MXACE/Edge-Device-Extension/README.md

# Edge-Device-Extension
Edge-Device, Node-Red, expansion board
https://docs.google.com/viewer?url=
