MXACE/Edge-Device-Extension/Extension-Board/COMMAND REFERENCE v1.1.pdf

# COMMAND REFERENCE v1.0

Extension board for the Edge Device

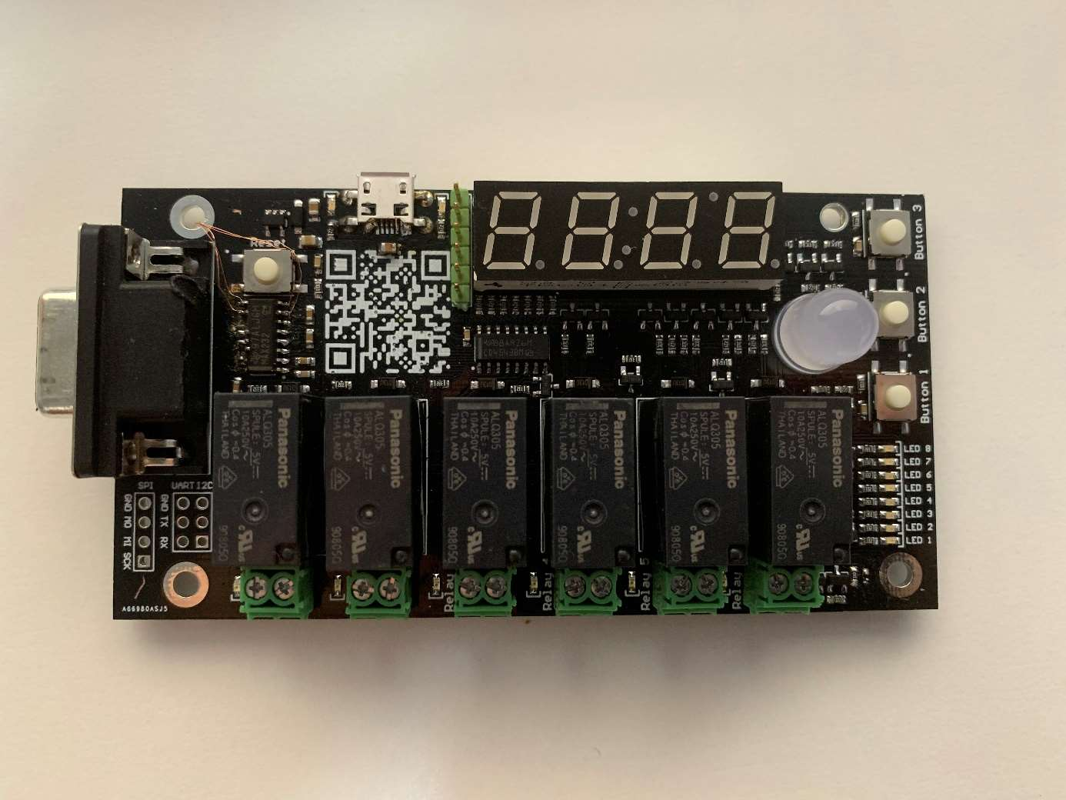
[picture p1: figure]

In this manual for the extension board v1.0 are supported command that can be sent over RS-232 (Serial) to control the parts on the PCB. Since the DSUB connector doesn’t supply the PCB with current, the Micro-USB connector on the top left has to be used. It is only for supply and can’t be used for communication.

### Serial settings:

Every sent command must end with a “;” to be completed, else it is still reading until he receives one. Every command received by the extension board comes with a “;” too.
Look at Page 9: Serial Settings for more detailed information.

### Baud-Rate: 115’200

## Inhalt

## RGB

You can set or read the current color of the RGB led. There are only certain colors available. Colorcode

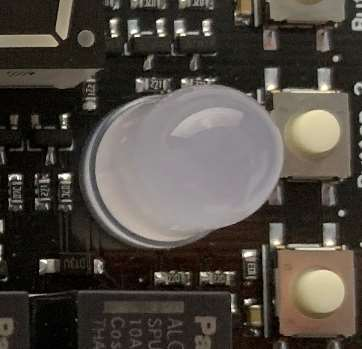
[picture p2: figure]

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
### SET

Set the RGB to the color with the color-code set.rgb.[color-code]
Example:
set.rgb.5;

### GET

Returns the current color of the RGB get.rgb
Example:
Received: | rgb.6;
Converted: | Yellow

## Relays

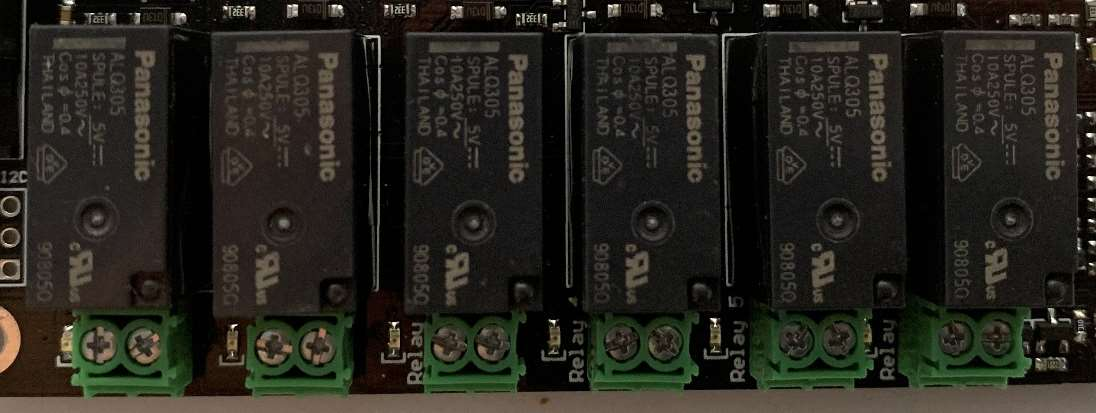
[picture p3: figure]

There are six relays that are able to switch 230V AC (but not recommended). If the relay is set a red led will shine on the left side of it.
You can connect it through the green terminal below it.
They are numbered from left to right and 1 to 6.

### SET

Turn the selected relay on or off
State:
0 -> off
1 -> on
set.relay.[relay number].[state]

Example:
set.relay.1.1;

### GET

Get the state of the relay get.relay.[relay number]
Example:
Received: | relay.3.1;
Converted: | ON

## LEDs

There are 8 green LEDs that can be turned on or off. They are numbered from 1 to 8.

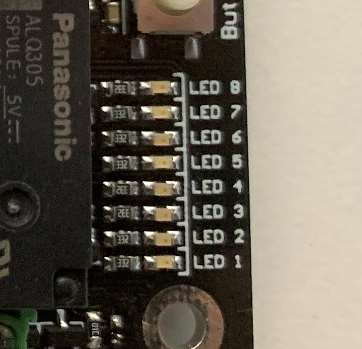
[picture p4: figure]

### SET

Turn the selected LED on or off State:
0 -> off
1 -> on
set.led.[led number].[state] Example:
set.led.4.1;

### GET

Returns the state of the relay get.led.[led number]

Example:
Received: | led.3.1;
Converted: | ON

## 7 Segment

The segment display can individually show numbers on each position, you can choose where the decimal point is, turn the colon or the upper point on. The display shines in green and can only show numbers.

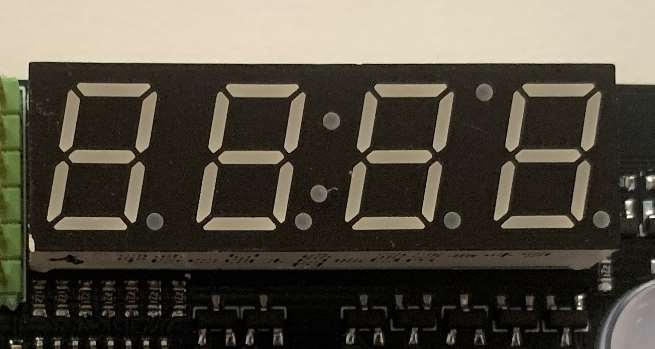
[picture p5: figure]

### SET

The position of the single digit: Pos. 1 -> X000
Pos. 2 -> 0X00
Pos. 3 -> 00X0
Pos. 4 -> 000X
dp pos -> decimal point position. Can be from 1 to 4. colon -> colon state, 1 = on, 0 = off.
upper -> upper point, 1 = on, 0 = off.

set.segment.[pos. 1][pos. 2][pos. 3][pos. 4].[dp pos].[colon].[upper]

Example:
set.segment.1234.0.1.0
Display shows: 12:34

## Temperature

Used to measure the room temperature.

Problem:
The longer the PCBs is turned on the more the sensor heat itself up. It will rise up a few Celsius.

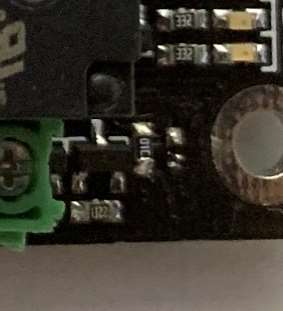
[picture p6: figure]

### GET

Returns the temperature as one number

get.temp

Example:
Received: | 2918;
Converted: | 29.18°C

### SHOW

The temperature can be show on the display with this command: set.showTemp.[state]
If you turn it off (state=0) the display shows 0000.

## Buttons

Used as an input source for the edge device
Sometimes it could trigger a fault state if the input can’t be read through the edge device. Only way to fix is, to reset (or repower) the extension board.

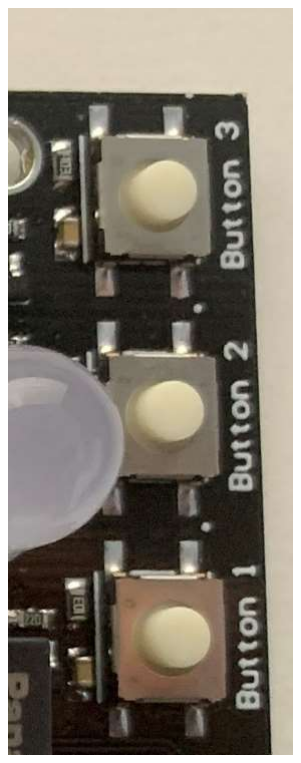
[picture p7: figure]

### GET

There is no command required. When a button is pressed one of the following returns can be received when pressed:
BUTTON1;
BUTTON2;
BUTTON3;

## Serial Settings

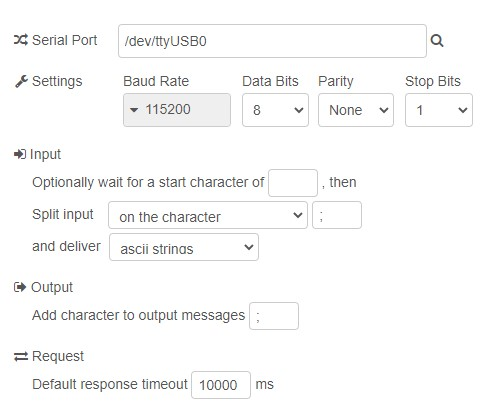
[picture p8: figure]

## Functions examples

All function codes can be found on the github.

### Read buttons

If the buttons are pressed you get into one of the following if-statements.
There you can set msg.payload that will be sent on the output of the function node.

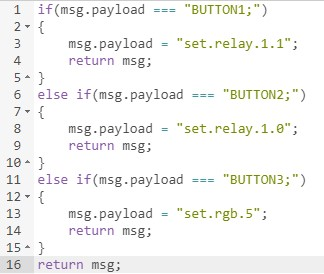
[picture p9: figure]

### Control the rgb led with the color picker node

Since they are only a few colors which the rgb led can show, it will automatically set the closest color. Color picker node settings:

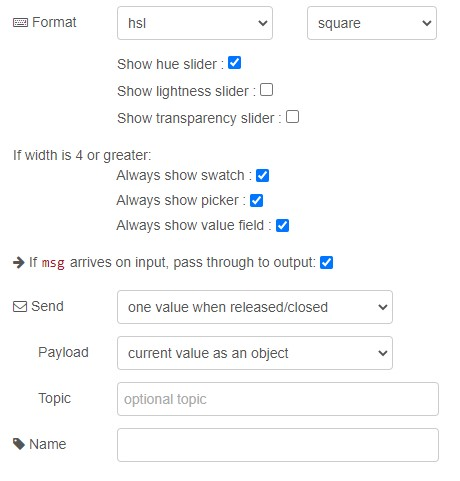
[picture p10: figure]

Function node

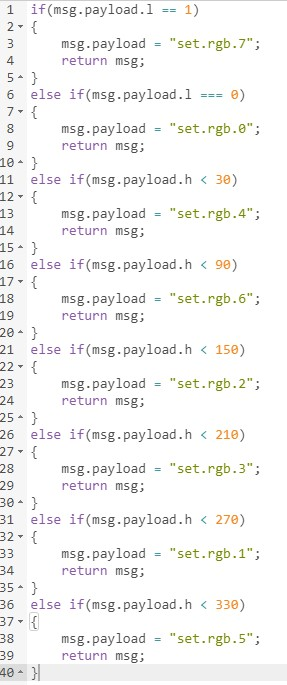
[picture p11: figure]

Set it up like this:
Color picker -> function -> serial out

### Use variables

Variables are here to store data if you need to, but there are a few types of them:
Temporary variable -> | Normal variable
Locally in function node -> | Context variable
Reachable from flow -> | Flow variable
Reachable from everywhere -> Global variable

Normal variable
It is initialized with “var” and followed by the name you want to give the variable.
If you wish to, you can declare it already at the beginning with “=” and a value, like a number a text in “”, or another variable writing its name there.

Here the variable names are VarA, VarB and VarC.
These types of variables only exists in the same function node and in every run of this node the variables will be forgotten (lose their saved values);

Context variables
Here you can save your variables locally in you function node without losing them every cycle.

Create/Set Flow variables
To create the variable, you must use the command:

Read Global variables
To read one of the existing variables you simply just add one of the following commands:

Flow variables.
This type of variables are based on the normal ones, but are reachable in the same flow. That means: multiple function nodes can read/change the variable.
Create/Set Flow variables
To create the variable, you must use the command:

Where “0” is the value of your variable (it can be another variable name).
Read Flow variables
To read one of the existing variables you simply just add one of the following commands:

You can either check the variable if it’s true or has a certain value.
Or you can set another new/existing variable with the value of the flow variable.

Global variables
Follows the same rules as Flow variables, but they are from every flow and function node reachable.

Create/Set Global Variables
To create the variable, you must use the command:

Read Global variables
To read one of the existing variables you simply just add one of the following commands:
