MXACE/Edge-Device-Extension/Projekt/Dokumentation/Plakat.pdf

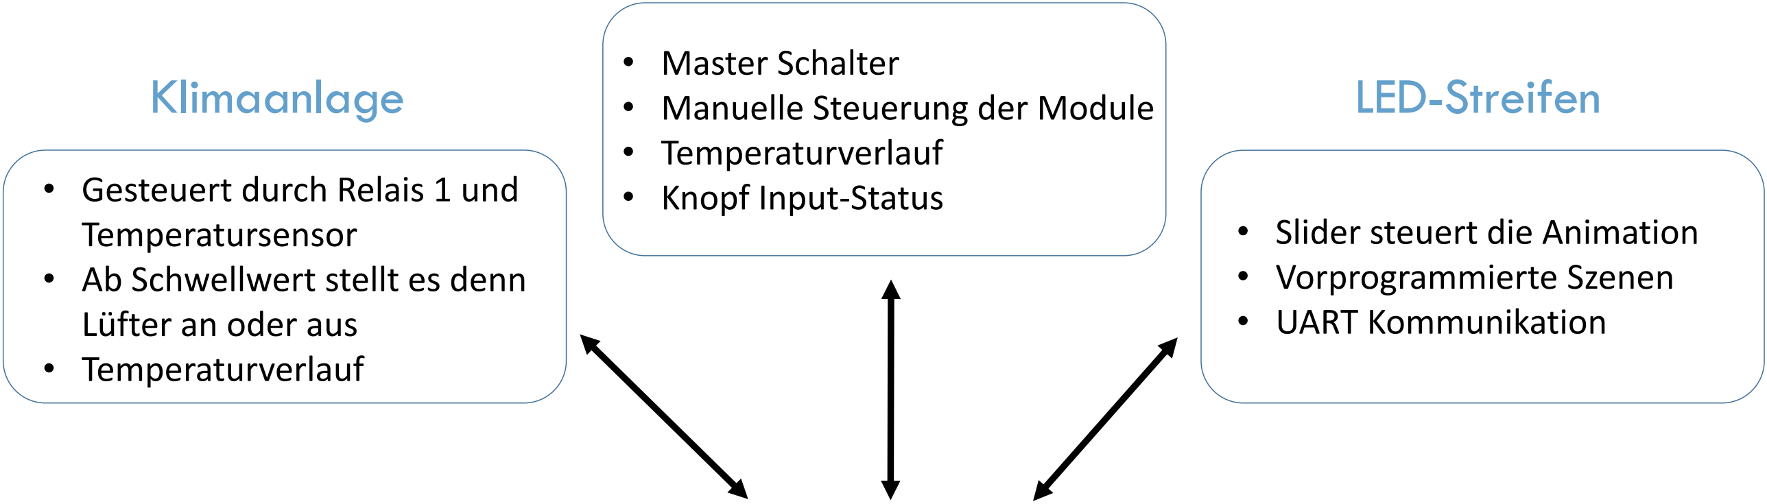
[picture p19: figure]
• Master Schalter • Manuelle Steuerung der Module • Temperaturverlauf • Knopf Input-Status; Klimaanlage; LED-Streifen; • Gesteuert durch Relais 1 und Temperatursensor • Ab Schwellwert stellt es denn Lüfter an oder aus • Temperaturverlauf; • Slider steuert die Animation • Vorprogrammierte Szenen • UART Kommunikation
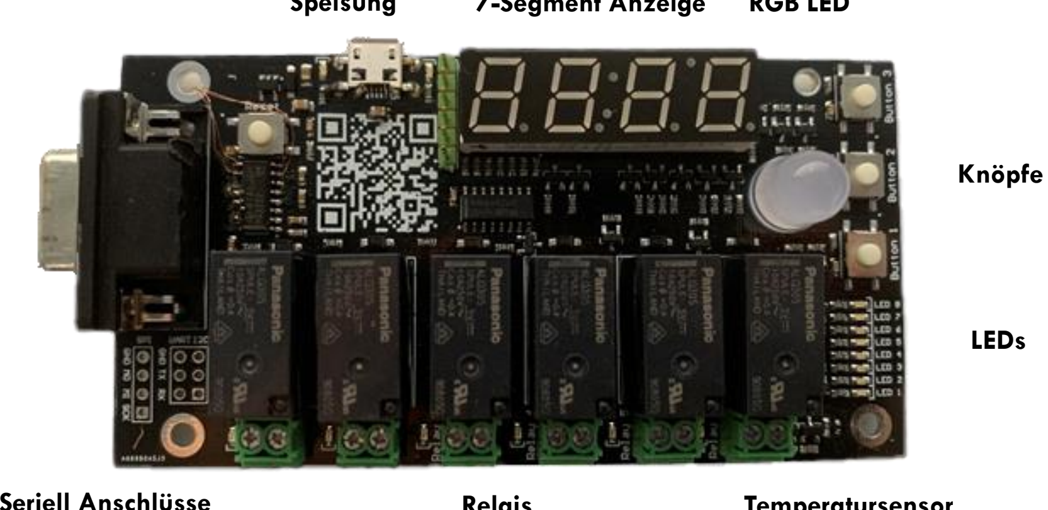
[picture p20: figure]
LEDs; Knöpfe
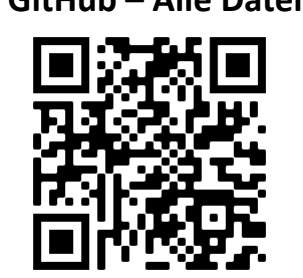
[picture p21: figure]

# Erweiterung für das Node-Red

## Marco Stauber

7-Segment Anzeige

Seriell Anschlüsse | Relais

RS232/
Seriell
Speisung | RGB LED

Temperatursensor

### Control Panel

Module
6x Schaltbare Relais (Schliesser)
8x Grüne LEDs
1x RGB LED (7 verschiedene Farben) 1x 4-Stellige 7-Segment Anzeige
3x Knöpfe
1x I

2C Anschluss (Nicht programmiert) 1x SPI Anschluss (Nicht programmiert) 1x Uart Anschluss

GitHub – Alle Daten
