MXACE/Edge-Device-Extension/Extension-Board/stückliste.xlsx

Part | What | Supplier | Supplier nr. | amount | price/piece | price total |  | digikey price |  | digikey new supply number
 |  |  |  |  |  | $0.00
 | Relays | seeed | G5NB-1A-E-DC5 | 6 | $0.69 | $4.14 |  | CHF 1.70 | CHF 51.13 | Z2771-ND |  | CHF 0.86 | CHF 25.87 | 255-3559-ND | CHF 20.70
 | STM32F401RBT6 | seeed | STM32F401RBT6 | 1 | $4.70 | $4.70 |  | CHF 4.32 | CHF 21.60 | 497-17428-ND |  |  | CHF 21.60 |  | CHF 17.28
 | max232 | seeed | MAX232DR | 1 | $0.46 | $0.46 |  | CHF 0.55 | CHF 2.75 | 296-14619-1-ND |  |  | CHF 2.75 |  | CHF 2.20
 | terminal 2pin 3.5mm | seeed | 1751248 | 6 | $1.05 | $6.30 |  | CHF 1.21 | CHF 36.21 | 277-5719-ND |  | CHF 0.45 | CHF 13.50 | 1984617 | CHF 10.80
 | led red | seeed | LTST-C191KRKT | 6 | $0.07 | $0.42 |  | CHF 0.19 | CHF 5.64 | 160-1447-1-ND |  | CHF 0.14 | CHF 4.20 | 732-4978-1-ND | CHF 3.36
 | led green | seeed | LTST-C191KGKT | 10 | $0.07 | $0.75 |  | CHF 0.19 | CHF 9.40 | 160-1446-1-ND |  | CHF 0.16 | CHF 7.95 | 732-12017-1-ND | CHF 6.36
 | bcd 7segment | seeed | CD4543BM96 | 1 | $0.47 | $0.47 |  | CHF 0.38 | CHF 1.90 | 296-31539-1-ND |  |  | CHF 1.90 |  | CHF 1.52
 | button | seeed | EVQQ2U02W | 4 | $0.18 | $0.72 |  | CHF 0.28 | CHF 5.60 | P12954SCT-ND |  | CHF 0.12 | CHF 2.40 | P12932SCT-ND | CHF 1.92
 | 3.3V | seeed | SPX1117M3-L-3-3 / TR | 1 | $0.22 | $0.22 |  | CHF 0.30 | CHF 1.49 | 1016-1848-1-ND | anderer footprint! | CHF 0.11 | CHF 0.55 | 576-4764-1-ND | CHF 0.44
 | temperatur sensor | seeed | KTY81 / 110,112 | 1 | $0.02 | $0.02 |  | CHF 1.42 | CHF 7.10 | 568-1003-ND | anderer footprint! | CHF 0.22 | CHF 1.10 | 296-TMP6131DECRCT-ND | CHF 0.88
 | schotky diode | seeed | PMEG4010EH, 115 | 7 | $0.08 | $0.55 |  | CHF 0.23 | CHF 8.18 | 1727-3880-1-ND |  | CHF 0.13 | CHF 4.59 | 1655-1926-1-ND | CHF 3.67
 | 26mhz crystal | seeed | SX25Y026000B91T | 1 | $0.10 | $0.10 |  | CHF 0.00 | CHF 0.00 |  |  | CHF 0.35 | CHF 1.75 | SER4105CT-ND | CHF 1.40
 | 7 segment | digikey | https://www.digikey.ch/product-detail/de/vishay-semiconductor-opto-division/TDCG1060M/TDCG1060M-ND/4074707 | 1 | $2.85 | $2.85 |  | CHF 2.85 | CHF 14.25 | TDCG1060M-ND |  |  | CHF 14.25 |  | CHF 11.40
 | transistor | seeed | MMBT3904-7-F | 24 | $0.02 | $0.50 |  | CHF 0.04 | CHF 5.22 | MMBT3904-FDICT-ND |  |  | CHF 5.22 |  | CHF 4.18
 | 10uF 0805 25V | seeed | GRM21BR61E106KA73L | 5 | $0.05 | $0.26 |  | CHF 0.18 | CHF 4.40 | 490-5523-1-ND |  | CHF 0.14 | CHF 3.60 | 1276-6454-1-ND | CHF 2.88
 | 100nF 0603 50V | seeed | C0603C104Z3VACTU | 11 | $0.02 | $0.22 |  | CHF 0.03 | CHF 1.70 | 399-1100-1-ND |  |  | CHF 1.71 |  | CHF 1.36
 | usb micro b | seeed | 473460001 | 1 | $1.30 | $1.30 |  | CHF 1.03 | CHF 5.15 | WM17141CT-ND | anderer footprint! | CHF 0.36 | CHF 1.80 | 2057-MCR-B-S-RA-SMT-EH4B-T/RCT-ND | CHF 1.44
 | 3k ohm 0603 | seeed | RC0603JR-073K3L | 14 | $0.0013 | $0.02 |  | CHF 0.02 | CHF 1.33 | 311-3.3KGRCT-ND |  |  | CHF 1.33 |  | CHF 1.06
 | 165k ohm 0603 | seeed | RC0603FR-07165KL | 8 | $0.002 | $0.02 |  | CHF 0.02 | CHF 0.92 | 311-165KHRCT-ND |  |  | CHF 0.92 |  | CHF 0.74
 | 270 ohm 0603 | seeed | RC1206FR-07270RL | 21 | $0.01 | $0.10 |  | CHF 0.02 | CHF 2.42 | 311-270HRCT-ND |  |  | CHF 2.42 |  | CHF 1.93
 | 11k ohm 0603 | seeed | RC0603FR-0711K5L | 10 | $0.003 | $0.03 |  | CHF 0.02 | CHF 1.15 | 311-11.5KHRCT-ND |  |  | CHF 1.15 |  | CHF 0.92
 | 22pf 0603 50V | seeed | CL10C220JB8NNNC | 2 | $0.01 | $0.02 |  | CHF 0.06 | CHF 0.61 | 1276-1023-1-ND |  |  | CHF 0.61 |  | CHF 0.49
 | 10k ohm 0603 | seeed | RC0603JR-0710KL | 5 | $0.001 | $0.01 |  | CHF 0.02 | CHF 0.47 | 311-10KGRCT-ND |  |  | CHF 0.47 |  | CHF 0.38
 | 1.3k ohm 0603 | seeed | RC0603JR-071K3L | 1 | $0.0013 | $0.0013 | 1 | CHF 0.02 | CHF 0.10 | 311-1.3KGRCT-ND |  |  | CHF 0.19 |  | CHF 0.15
 | dsub 9 | digikey | 618009231121 | 1 | $2.63 | $2.63 |  | CHF 2.63 | CHF 13.15 | 732-618009231121-ND |  |  | CHF 13.15 |  | CHF 10.52
 | 1uf 0603 25V | seeed | GCM188R71E105KA64D | 8 | $0.07 | $0.53 |  | CHF 0.19 | CHF 7.64 | 490-10673-1-ND |  | CHF 0.07 | CHF 2.96 | 311-1445-1-ND | CHF 2.37
 | FRB | seeed | BLM18AG102SN1D | 1 | $0.02 | $0.02 |  | CHF 0.10 | CHF 0.50 | 490-1015-1-ND |  |  | CHF 0.50 |  | CHF 0.40
 | 390 ohm 0805 | seeed | RC0805JR-07390RL | 1 | $0.002 | $0.002 | 1 | CHF 0.03 | CHF 0.17 | 311-390ARCT-ND |  |  | CHF 0.34 |  | CHF 0.28
 |  |  |  | 159 |  | $27.36 |  |  | $210.18 |  |  |  | CHF 138.78 |  | CHF 111.03 | CHF 27.76
 |  |  |  |  | SMD | THT |  |  |  |  |  | SMD | THT | mixed
 |  |  |  |  | 144 | 13 |  |  |  |  |  | 144 | 14 | 1
