MXACE/Edge-Device-Extension/Extension-Board/PCB/FilesForOrder/BOM.xls

 |  | xxxx xxxx xxxxx xxPCS BOM (Sample Bill of Materials)
Quantity | Designator | Description | Value | Footprint | Manufacturer | Part Number
8 | C1,C2,C3,C4,C5,C15,C16,C27 | 0603 | CAP CER 1UF 25V X5R 0603 | 0603 | Yageo | CC0603KRX5R8BB105
11 | C6,C7,C8,C9,C17,C18,C19,C20,C21,C24,C26 | 0603 | CAP CER 0.1UF 25V Y5V 0603 | 0603 | Murata Electronics | C0603C104Z3VACTU
5 | C10,C11,C12,C23,C25 | 0805 | CAP CER 10UF 25V X5R 0805 | 0805 | Samsung Electro-Mechanics | CL21A106KAYNNNG
2 | C13,C14 | 0603 | CAP CER 22PF 50V C0G/NP0 0603 | 0603 | Microchip | CL10C220JB8NNNC
7 | D1,D3,D5,D7,D9,D11,D24 | SOD-123FL | SCHOTTKY 30V SOD-123FL | SOD-123FL | SMC Diode Solutions | DSS13UTR
6 | D2,D4,D6,D8,D10,D12 | 0603 | LED RED CLEAR 0603 SMD | 0603 | Würth Elektronik | 150060RS75000
10 | D15,D16,D17,D18,D19,D20,D21,D22,D23,D25 | 0603 | LED GREEN DIFFUSED 0603 SMD | 0603 | Würth Elektronik | 150060VS55040
6 | K1,K2,K3,K4,K5,K6 |  | RELAY GEN PURPOSE SPST 10A 5V |  | Panasonic Electric Works | ALQ305
1 | L1 | 0603 | FERRITE BEAD 1 KOHM 0603 1LN | 0603 | Murata Electronics | BLM18AG102SN1D
6 | P3,P4,P5,P6,P7,P8 |  | TERM BLK 2POS SIDE ENT 3.5MM PCB |  | Phoenix Contact | 1984617
1 | P9 |  | MICRO USB, TYPE B, RIGHT ANGLE, |  | Muruta | MCR-B-S-RA-SMT-EH4B-T/R
21 | R1,R4,R7,R10,R12,R14,R16,R17,R20,R22,R23,R24,R25,R26,R27,R28,R29,R30,R31,R55,R56 | 0603 | RES SMD 270 OHM 1% 1/10W 0603 | 0603 | Yageo | RC0603FR-07270RL
14 | R2,R5,R8,R11,R13,R15,R40,R42,R44,R46,R48,R50,R52,R54 | 0603 | RES SMD 3.3K OHM 5% 1/10W 0603 | 0603 | Yageo | RC0603JR-073K3L
5 | R3,R6,R9,R59,R60 | 0603 | RES SMD 10K OHM 5% 1/10W 0603 | 0603 | Yageo | RC0603JR-0710KL
10 | R18,R19,R21,R32,R33,R34,R35,R36,R37,R38 | 0603 | RES SMD 11.5K OHM 1% 1/10W 0603 | 0603 | Yageo | RC0603FR-0711K5L
8 | R39,R41,R43,R45,R47,R49,R51,R53 | 0603 | RES SMD 165K OHM 1% 1/10W 0603 | 0603 | Yageo | RC0603FR-07165KL
1 | R57 | 0603 | RES SMD 1.3K OHM 5% 1/10W 0603 | 0603 | Yageo | RC0603JR-071K3L
1 | R58 | 0603 | RES SMD 390 OHM 5% 1/8W 0805 | 0603 | Yageo | RC0805JR-07390RL
4 | S1,S2,S3,S4 |  | SWITCH TACTILE SPST-NO 0.02A 15V |  | Panasonic Electronic Components | EVQ-Q2B03W
24 | T1,T2,T3,T4,T5,T6,T7,T8,T9,T10,T11,T12,T13,T14,T15,T16,T17,T18,T19,T20,T21,T22,T23,T24 | SOT23-3 | TRANS NPN 40V 0.2A SMD SOT23-3 | SOT23-3 | Diodes Incorporated | MMBT3904-7-F
1 | U1 | 16-SOIC | IC TRANSCEIVER FULL 2/2 16SOIC | 16-SOIC | Texas Instruments | MAX232DR
1 | U2 | 16-SOIC | IC DRVR 7 SEGMENT 1 DIGIT 16SOIC | 16-SOIC | Texas Instruments | CD4543BM96
1 | U3 | 0402 | SENSOR PTC 10KOHM 1% X1SON | 0402 | Texas Instruments | TMP6131DECR
1 | U4 | 64-LQFP | IC MCU 32BIT 128KB FLASH 64LQFP | 64-LQFP | STMicroelectronics | STM32F401RBT6
1 | U5 | SOT23-5 | IC REG LINEAR 3.3V 300MA SOT23-5 | SOT23-5 | Microchip Technology | MIC5504-3.3YM5-TR
1 | Y1 | 4-SMD | CRYSTAL 26.00 MHZ 9.0PF SMD | 4-SMD | EPSON | TSX-3225 26.0000MF09Z-AC0
1 | D14 | 16-DIP | CLOCKMODULE 10MM GREEN M.PLEX C. | 16-DIP | TDCG1060M-ND | TDCG1060M
1 | J1 |  | WR-DSUB FEMALE ANGLED PCB CONNEC |  | Würth Elektronik | 618009231121
