MXACE/Edge-Device-Extension/Extension-Board/PCB/PCB_Project/PCB Project Outputs/BOM/Bill of Materials-PCB_Project.xls

Comment | Description | Designator | Footprint | LibRef | Manufacturer | Manufacturer Part Number | Note | Quantity | Supplier | Supplier Part Number | Library Reference
1uF | capacitor | C1, C2, C3, C4, C5, C15, C16, C27 | CAP_0603i_1608m -N | Cap |  |  |  | 8 |  |  | Cap
100nF | capacitor | C6, C7, C8, C9, C17, C18, C19, C20, C21, C24, C26 | CAP_0603i_1608m -N | Cap |  |  |  | 11 |  |  | Cap
10uF | capacitor | C10, C11, C12, C23, C25 | CAP_0805i_2012m -N | Cap |  |  |  | 5 |  |  | Cap
22pF | capacitor | C13, C14 | CAP_0603i_1608m -N | Cap |  |  |  | 2 |  |  | Cap
Diode Schottky | Schottky Diode | D1, D3, D5, D7, D9, D11, D24 | SOD123 | Diode Schottky |  |  |  | 7 |  |  | Diode Schottky
Orange | LED; SMD; 0603; orange; 45-90mcd; 1.6x0.8x0.55mm; 130Â°; 2Ã·2.4V; 20mA | D2, D4, D6, D8, D10, D12 | *0603 | LTST-C191KFKT |  |  |  | 6 |  |  | LTST-C191KFKT
848 |  | D13 | Adafruit-848 | Adafruit-848 |  |  |  | 1 |  |  | Adafruit-848
7 Segment |  | D14 | TDCG1060M | TDCG1060M |  |  |  | 1 |  |  | TDCG1060M
Grün | LED; SMD; 0603; grün; 35mcd; 1.6x0.8x0.55mm; 130Â°; 2Ã·2.V; 20mA | D15, D16, D17, D18, D19, D20, D21, D22, D23, D25 | *0603 | LTST-C191KGKT |  |  |  | 10 |  |  | LTST-C191KGKT
618009231121 | Female PCB Connector with Hex Screw WR-DSUB, 8.08 mm, Angled, 9 pins | J1 | 618009231121 | CMP-1502-00200-1 | Wurth Elektronik |  |  | 1 |  |  | CMP-1502-00200-1
ALQ305 | LQ Relays, 5 V Coil Voltage, 200 mW Nominal Operating Power, -40 to 85 degC, 4-Pin LQ, Carton, Case, RoHS | K1, K2, K3, K4, K5, K6 | PNSC-LQ-4-2000x1000x1600_V | CMP-1503-00188-1 | Panasonic |  |  | 6 |  |  | CMP-1503-00188-1
Inductor | Inductor | L1 | IND_0603i_1608m -L | Inductor |  |  |  | 1 |  |  | Inductor
Header 4 | Header, 4-Pin | P1 | HDR1X4 | Header 4 |  |  |  | 1 |  |  | Header 4
Header 3X2 | Header, 3-Pin, Dual row | P2 | HDR2X3 | Header 3X2 |  |  |  | 1 |  |  | Header 3X2
Header 2 | Header, 2-Pin | P3, P4, P5, P6, P7, P8 | 3.5MM Phoenix Contact 1984617 | Header 2 |  |  |  | 6 |  |  | Header 2
USB Micro B |  | P9 | MCR-B-S-RA-SMT-EH4B-T/R | USB Mikro B |  |  |  | 1 |  |  | USB Mikro B
Temp | Single Pad or Testpoint | P10 | Pad_3x3mm | Pad |  |  |  | 1 |  |  | Pad
JTDI | Single Pad or Testpoint | P11 | Pad_0603 | Pad |  |  |  | 1 |  |  | Pad
MC | Single Pad or Testpoint | P12 | Pad_3x3mm | Pad |  |  |  | 1 |  |  | Pad
Header 6 | Header, 6-Pin | P13 | HDR1X6 | Header 6 |  |  |  | 1 |  |  | Header 6
270 | Resistor | R1, R4, R7, R10, R12, R14, R16, R17, R20, R22, R23, R24, R25, R26, R27, R28, R29, R30, R31, R55, R56 | RES_0603i_1608m -N | Res |  |  |  | 21 |  |  | Res
3k | Resistor | R2, R5, R8, R11, R13, R15, R40, R42, R44, R46, R48, R50, R52, R54 | RES_0603i_1608m -N | Res |  |  |  | 14 |  |  | Res
10k | Resistor | R3, R6, R9, R59, R60 | RES_0603i_1608m -N | Res |  |  |  | 5 |  |  | Res
11k | Resistor | R18, R19, R21, R32, R33, R34, R35, R36, R37, R38 | RES_0603i_1608m -N | Res |  |  |  | 10 |  |  | Res
165k | Resistor | R39, R41, R43, R45, R47, R49, R51, R53 | RES_0603i_1608m -N | Res |  |  |  | 8 |  |  | Res
1.3k | Resistor | R57 | RES_0603i_1608m -N | Res |  |  |  | 1 |  |  | Res
390 | Resistor | R58 | RES_0805i_2012m -N | Res |  |  |  | 1 |  |  | Res
10k,ptc | temp sensor, ptc 10k | R61 | RES_0402i_1005m -N | Res |  |  |  | 1 |  |  | Res
EVQ-Q2U02W | White Button Tactile Switch, Single Pole Single Throw (SPST) 20 mA @ 15 V dc 0.7mm | S1, S2, S3, S4 | EVQQ2 | EVQ-Q2U02W |  |  |  | 4 |  |  | EVQ-Q2U02W
Part Number: MMBT3904-7-F | No Description Available | T1, T2, T3, T4, T5, T6, T7, T8, T9, T10, T11, T12, T13, T14, T15, T16, T17, T18, T19, T20, T21, T22, T23, T24 | SOT-23-M | MMBT3904-7-F |  |  |  | 24 |  |  | MMBT3904-7-F
MAX232DR | Dual EIA-232 Driver / Receiver, 0 to 70 degC, 16-Pin SOIC (D), Green (RoHS & no Sb/Br) | U1 | D0016A_N | CMP-0299-00150-2 |  |  |  | 1 |  |  | CMP-0299-00150-2
CD4543BM96 | CMOS BCD-to-7-Segment Latch / Decoder / Driver for Liquid-Crystal Displays, 3 V, -55 to 125 degC, 16-pin SOIC (D16), Green (RoHS & no Sb/Br) | U2 | D0016A_L | CMP-0388-00008-2 | Texas Instruments |  |  | 1 |  |  | CMP-0388-00008-2
MIC5504-3.3YM5-TR | Single LDO, 2.5 to 5.5 V, Fixed Out 3.3 V, 0.3 A, -40 to 125 degC, 5-Pin SOT-23 (M5), RoHS, Tape and Reel | U3 | MCHP-SOT-23-M5_V | CMP-2000-07604-1 | Microchip |  |  | 1 |  |  | CMP-2000-07604-1
STM32F401RBT6 | ARM Cortex-M4 32-bit MCU+FPU, 105 DMIPS, 128 kB Flash, 64 kB Internal RAM, 48 I/Os, 64-pin LQFP, -40 to 85 degC, Tray | U4 | STM-LQFP64_L | CMP-0243-00094-2 | STMicroelectronics |  |  | 1 |  |  | CMP-0243-00094-2
XTAL3 | Industrial Ceramic Resonator | Y1 | TSX-3225 2*2.5 | XTAL3 |  |  |  | 1 |  |  | XTAL3
