MXACE/Edge-Device-Extension/Projekt/Klimaanlage/cad/lüfterhalter.SLDPRT

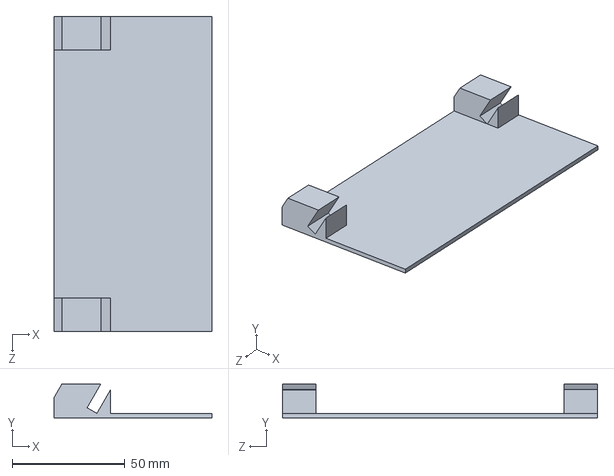
[picture p24: CAD file, 2020-10-02]
Projekt/Klimaanlage/cad/lüfterhalter.SLDPRT
70.0 x 15.0 x 140.0 mm
