MXACE/Edge-Device-Extension/(list of files, cad)

Other CAD files:
Projekt/Klimaanlage/cad/lüfterhalter.STL
