MXACE/Edge-Device-Extension/Extension-Board/PCB/PCB_Project/PCB Project Outputs/Schematics.PDF

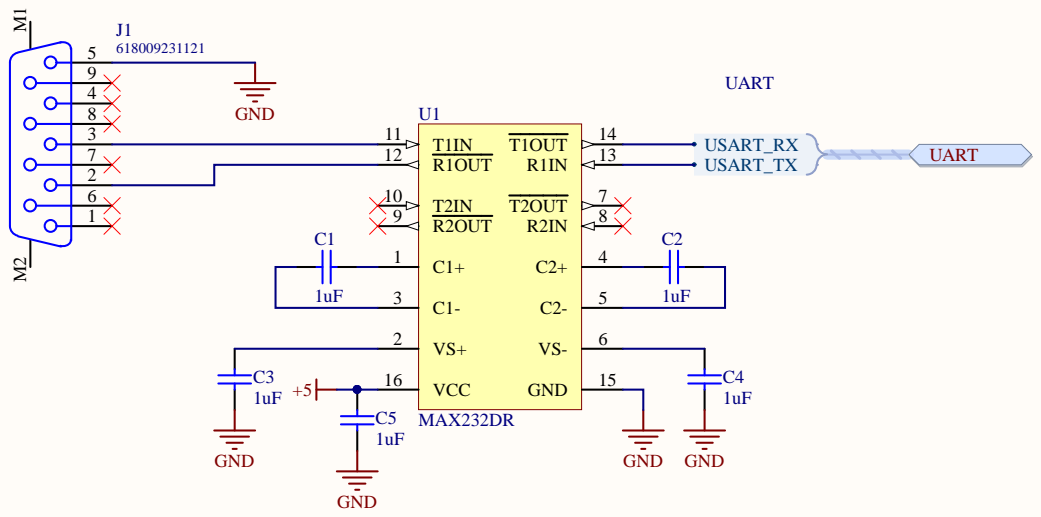
[picture p25: page 1]

Pro jec t : *

Dra w i n g n u m ber : * Rev: Dat e : 25. 09. 202 0 14: 03: 5 2 | For m a t : A 3 | Labor ato ry : Dra w n b y : | S h eet : C O M . SchDo c Pag e o f

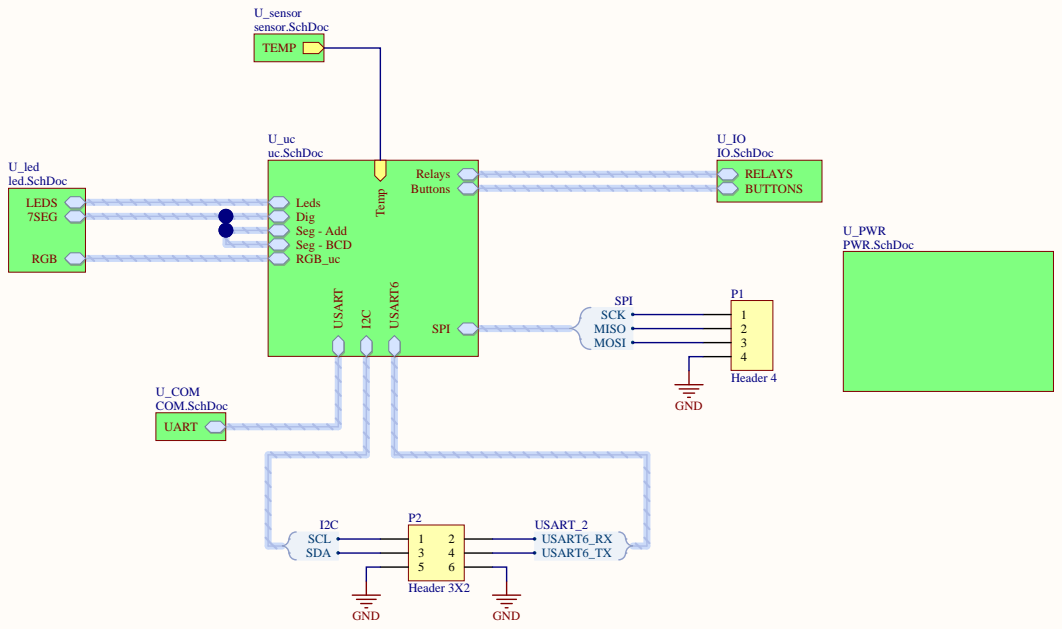
[picture p26: page 2]

Project: *

Drawing number: * Rev: * Date: 25.09.2020 14:03:53 | Format: A3 | Laboratory: * Drawn by: | Sheet: extension.SchDoc Page * of *

D:\onedrive\OneDrive - TBZ\node-red\extensionv1.0\PCB_Project\extension.SchDoc

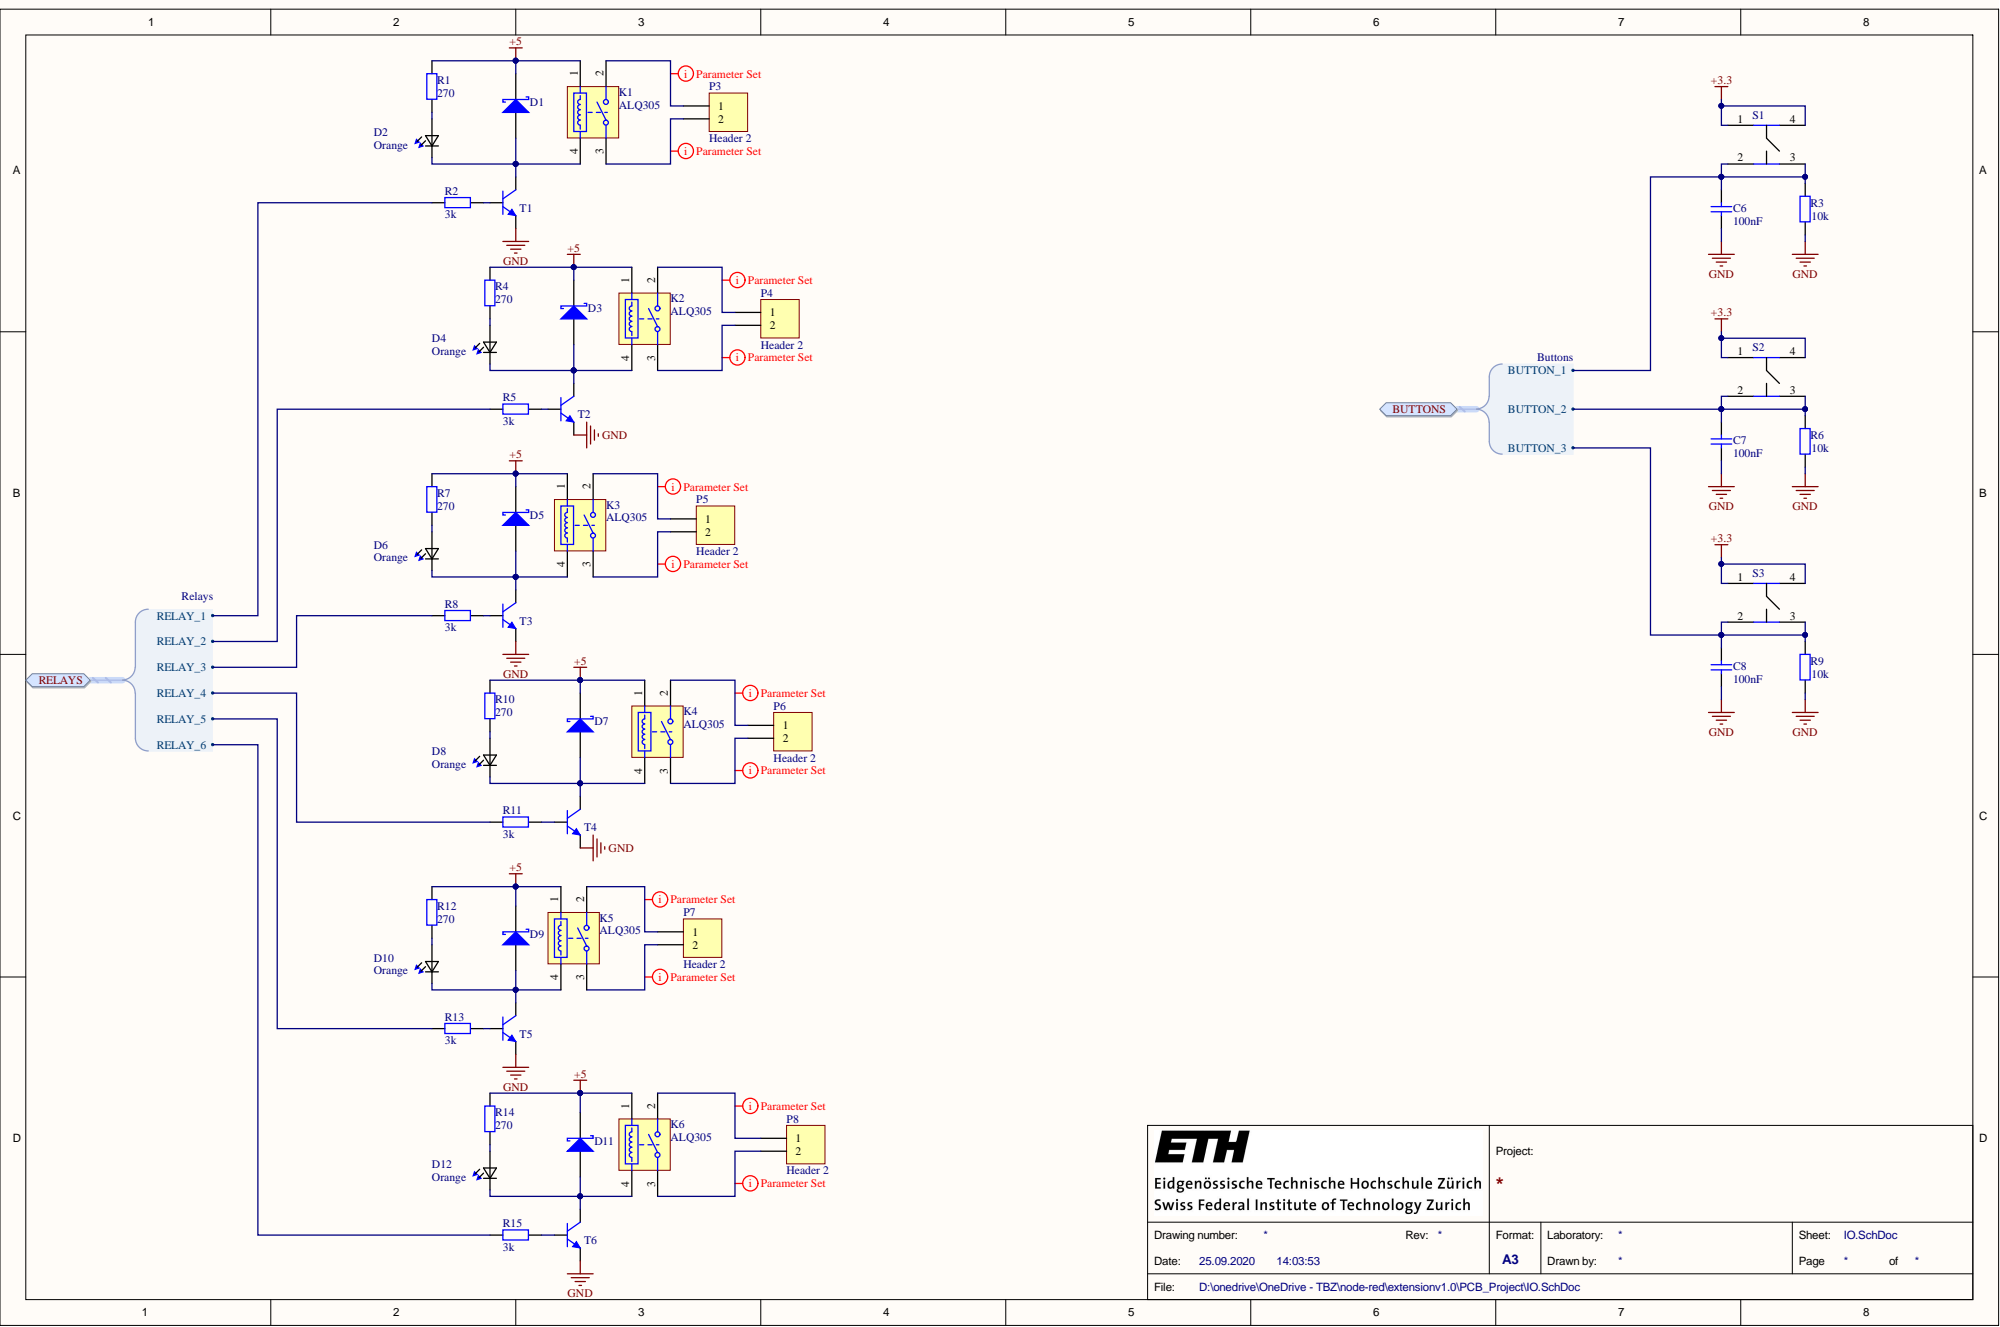
[picture p27: page 3]

i Parameter Set i Parameter Set i Parameter Set

D6 Orange

D8 Orange

D10 Orange

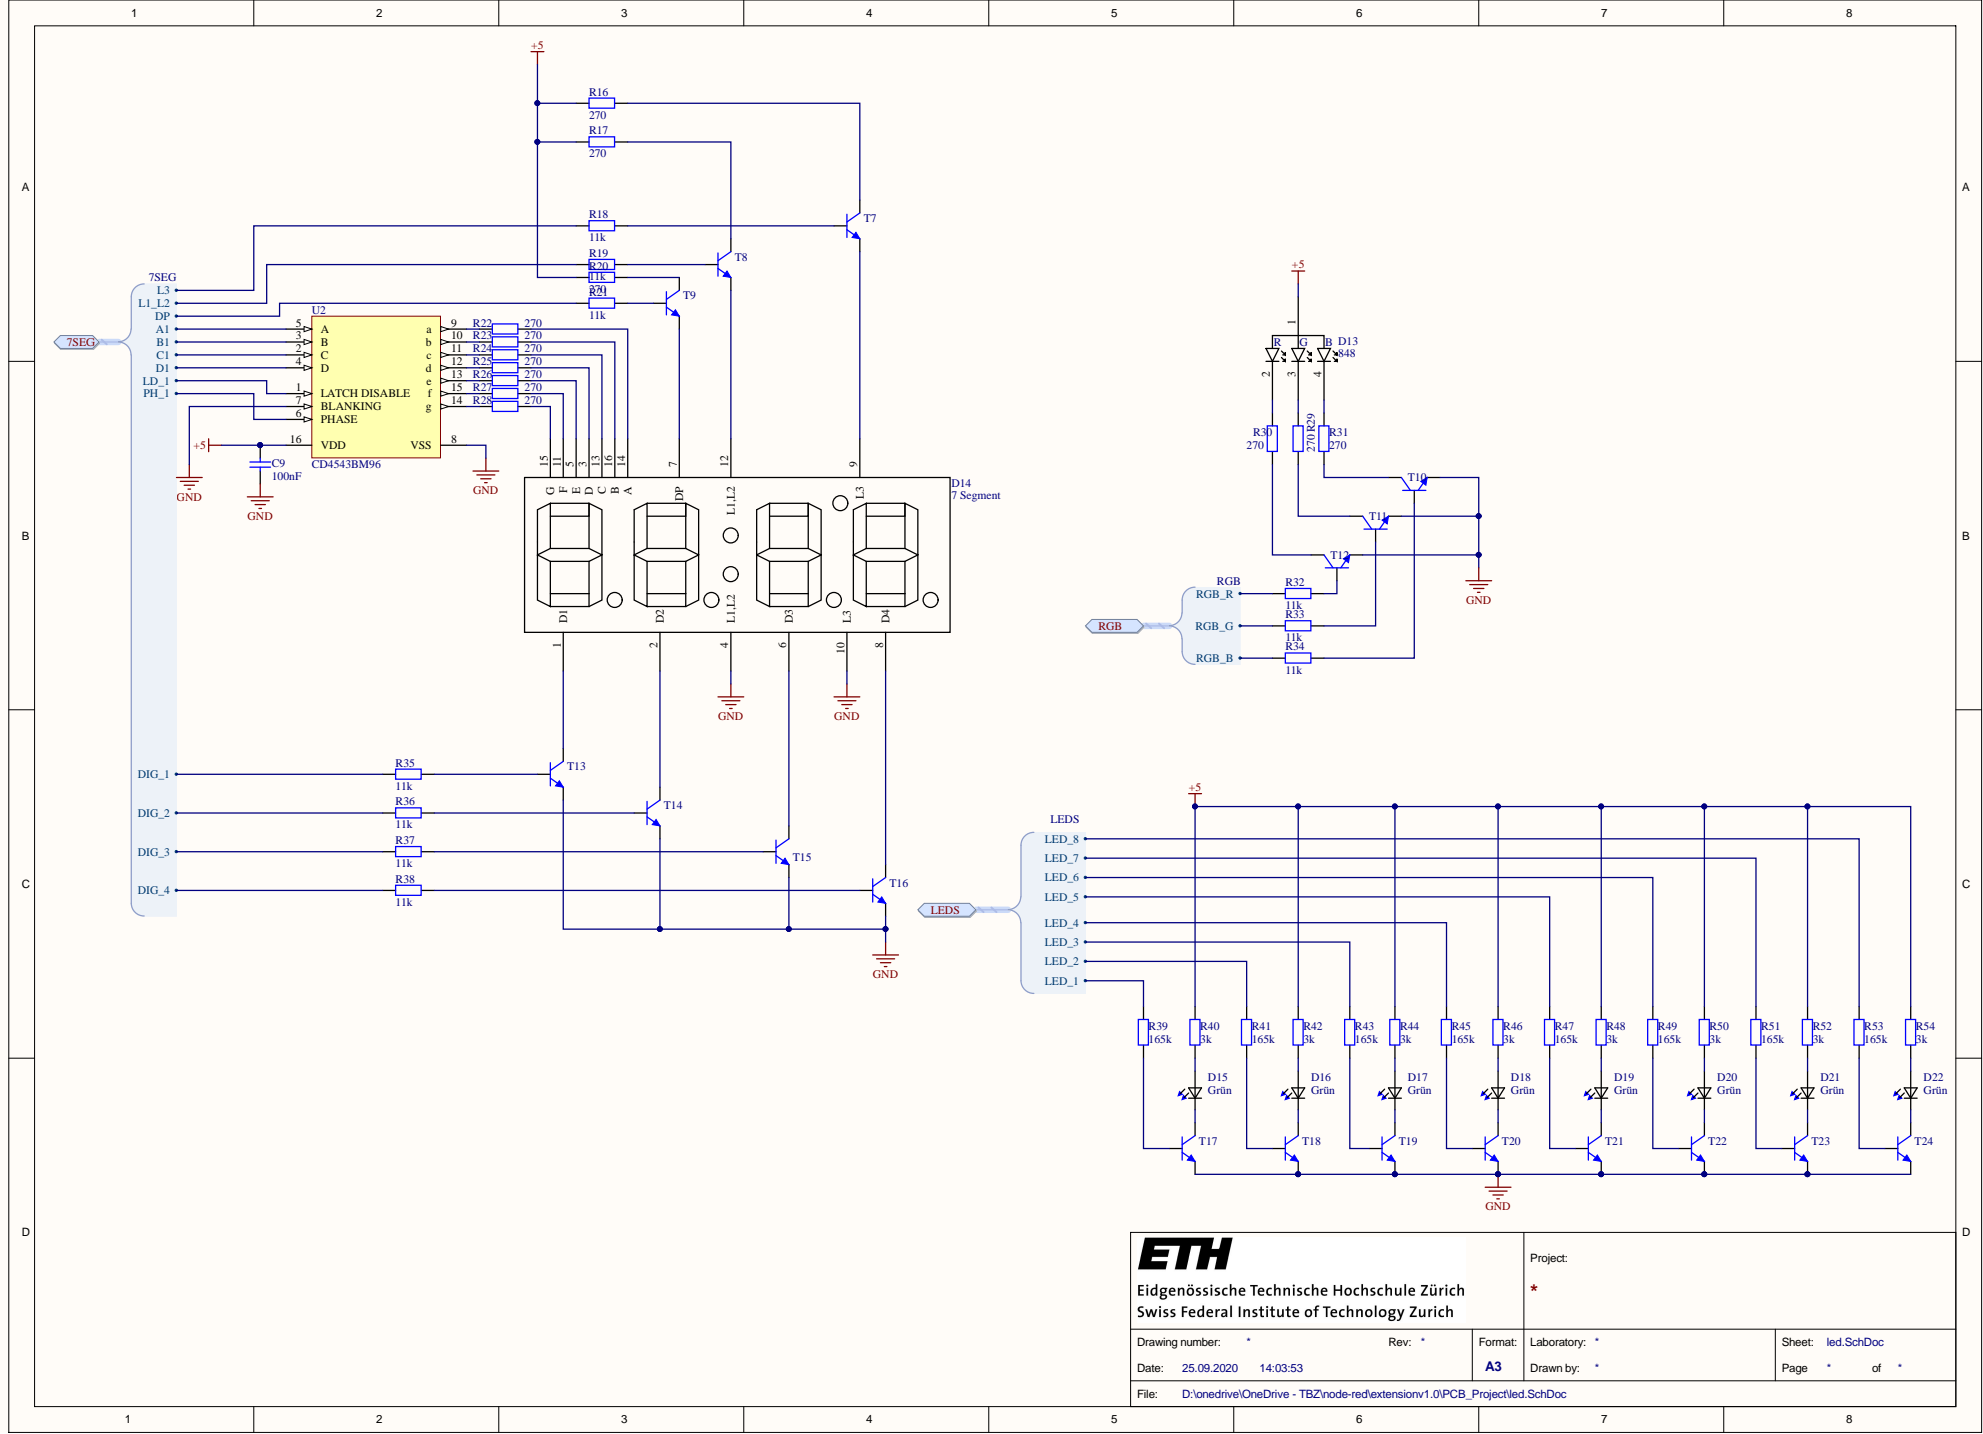
[picture p28: page 4]

A 5 b c d e g
C 2 B 3 | 10 R23 | | 270

D 4 | 12 R25 | | 270
LATCH DISABLE 1 | 13 R26 | | 270

PHASE 6 BLANKING 7 | R28 | 270

Project: *

Drawing number: * Rev: * Date: 25.09.2020 14:03:53 | Format: A3 | Laboratory: * Drawn by: | Sheet: led.SchDoc Page * of *

D:\onedrive\OneDrive - TBZ\node-red\extensionv1.0\PCB_Project\led.SchDoc

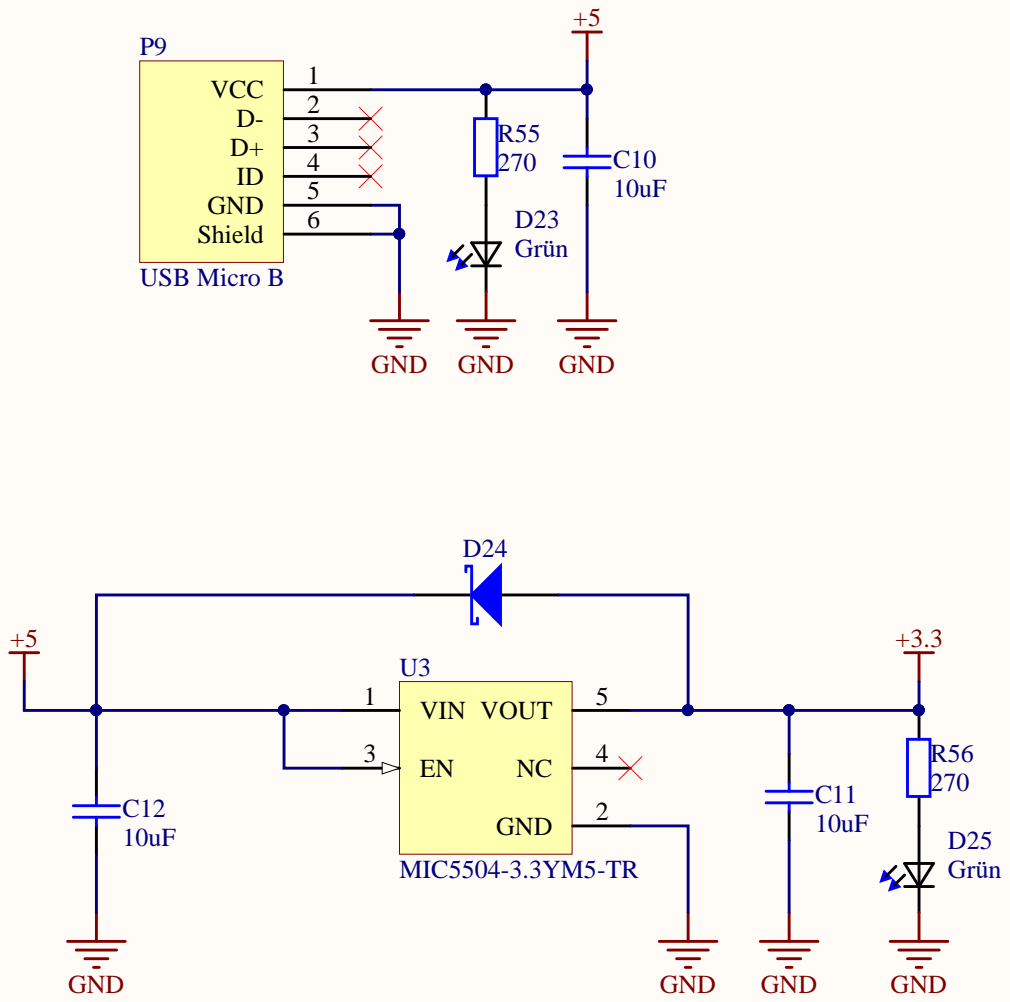
[picture p29: page 5]

Project: *

Drawing number: * Rev: * Date: 25.09.2020 14:03:54 | Format: A3 | Laboratory: * Drawn by: | Sheet: PWR.SchDoc Page * of *

D:\onedrive\OneDrive - TBZ\node-red\extensionv1.0\PCB_Project\PWR.SchDoc

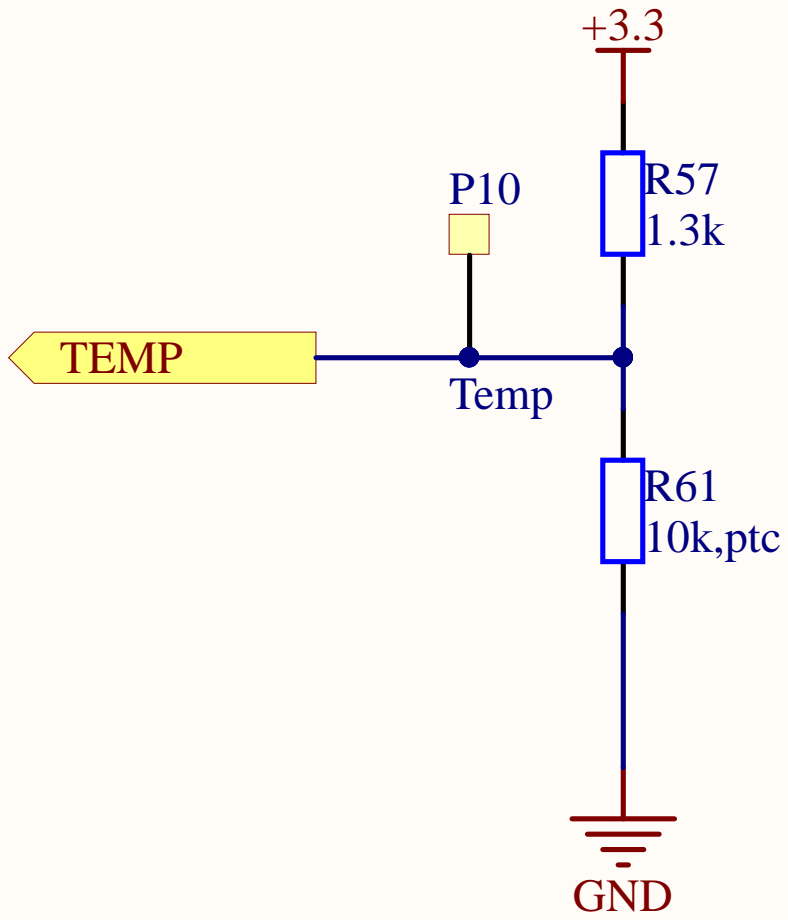
[picture p30: page 6]

Pro jec t : *

Dra w i n g n u m ber : Rev: Dat e : 25. 09. 202 0 14: 03: 5 4 | For m a t : A 3 | Labor ato ry : Dra w n b y : | S h eet : senso r.S c h Doc Pag e o f

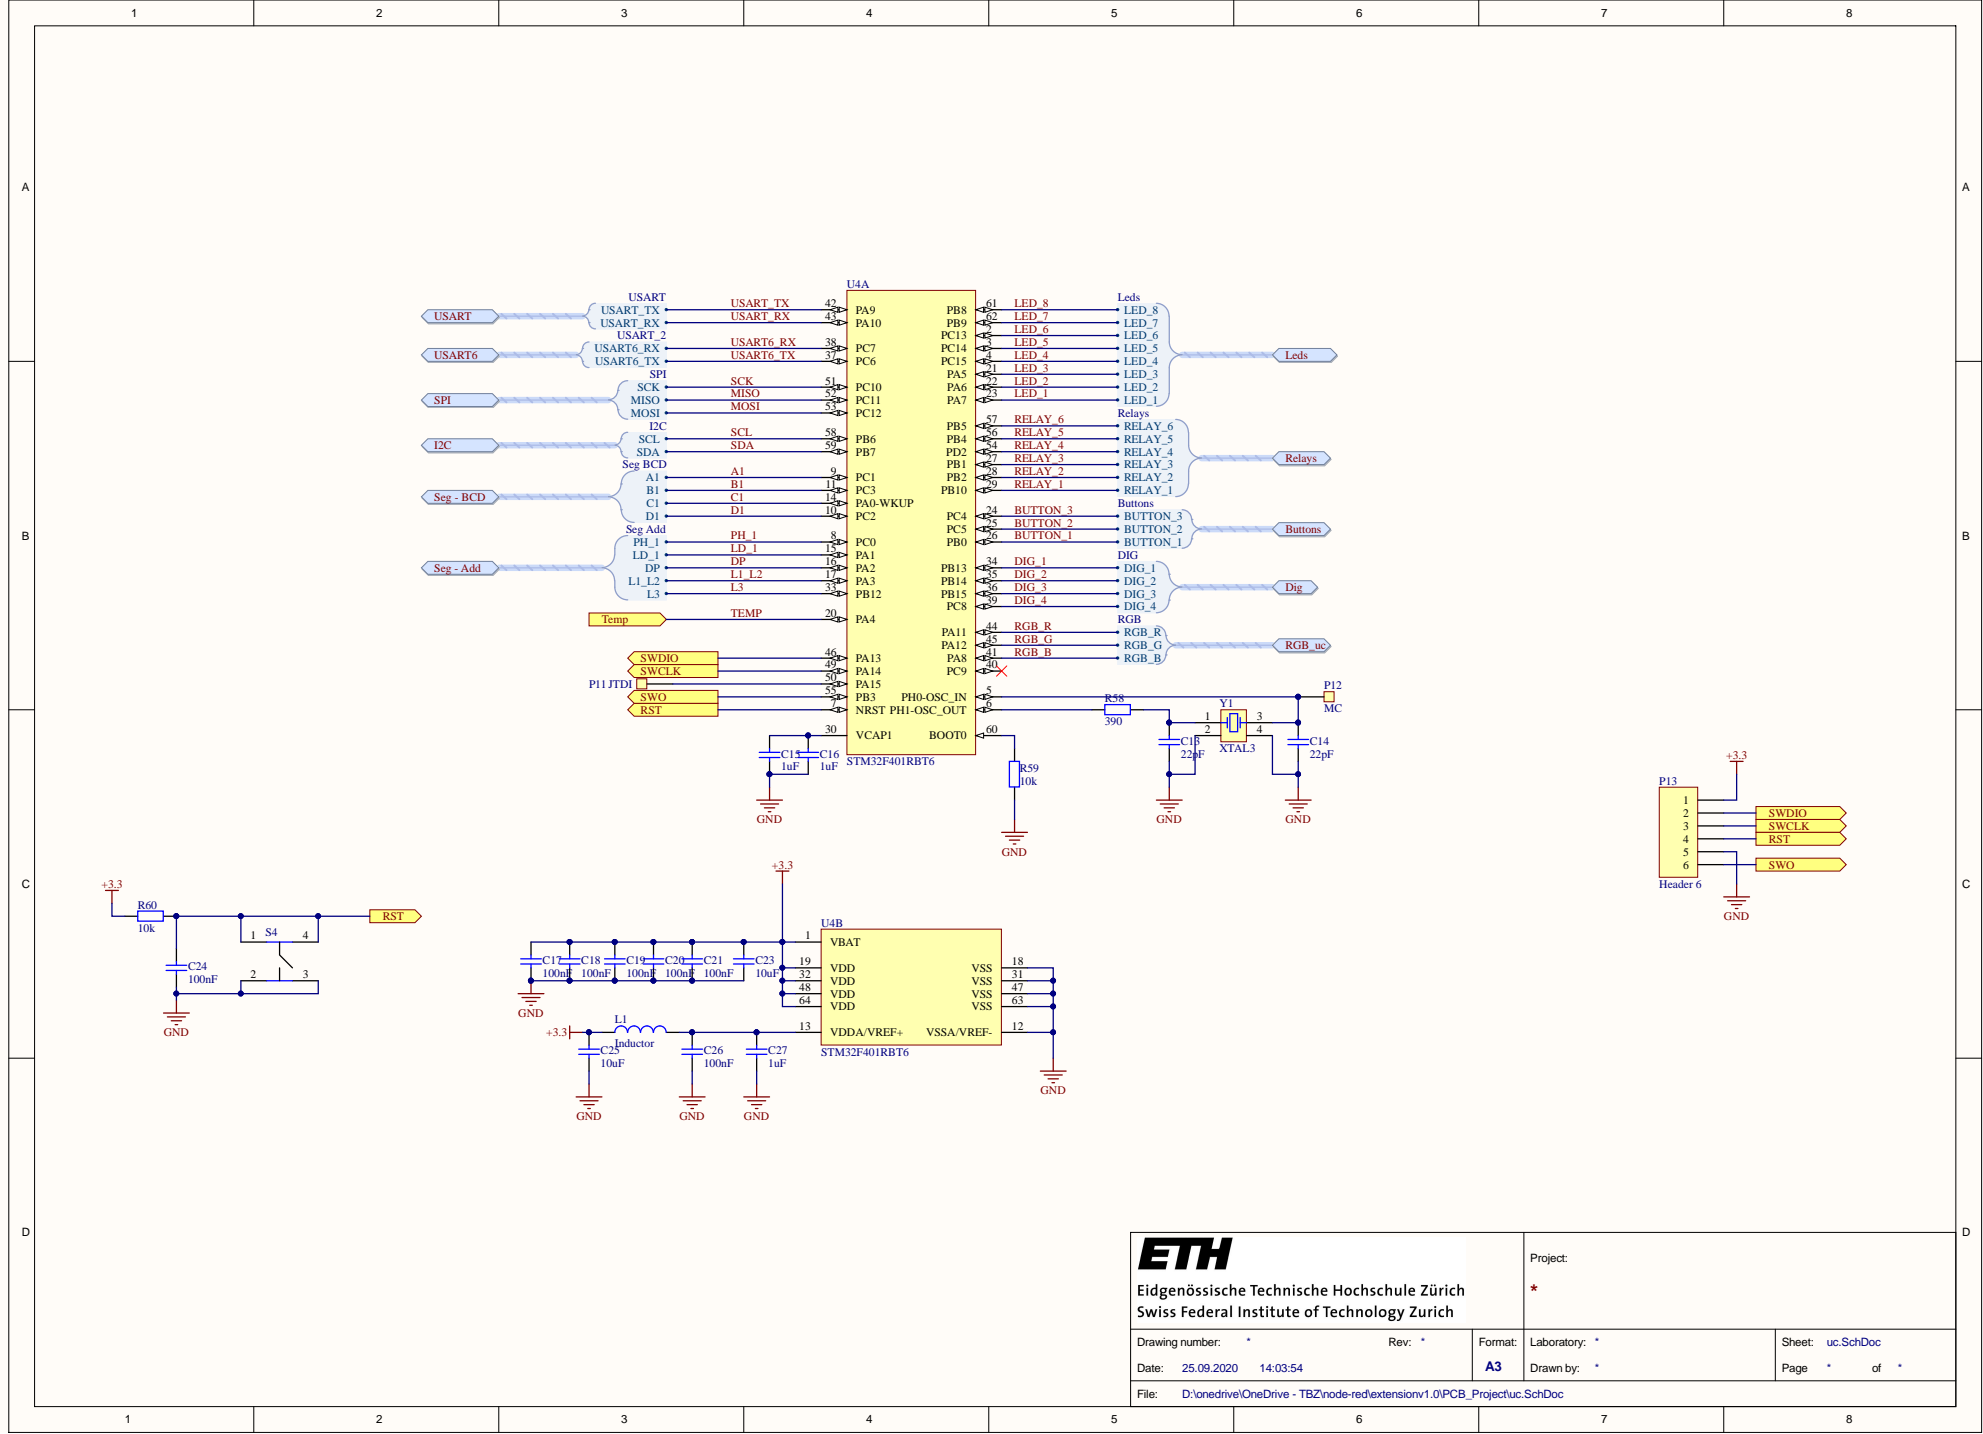
[picture p31: page 7]

Pro jec t : *

Dra w i n g n u m ber : Rev: Dat e : 25. 09. 202 0 14: 03: 5 4 | For m a t : A 3 | Labor ato ry : Dra w n b y : | S h eet : u c .Sc h D o c Pag e o f

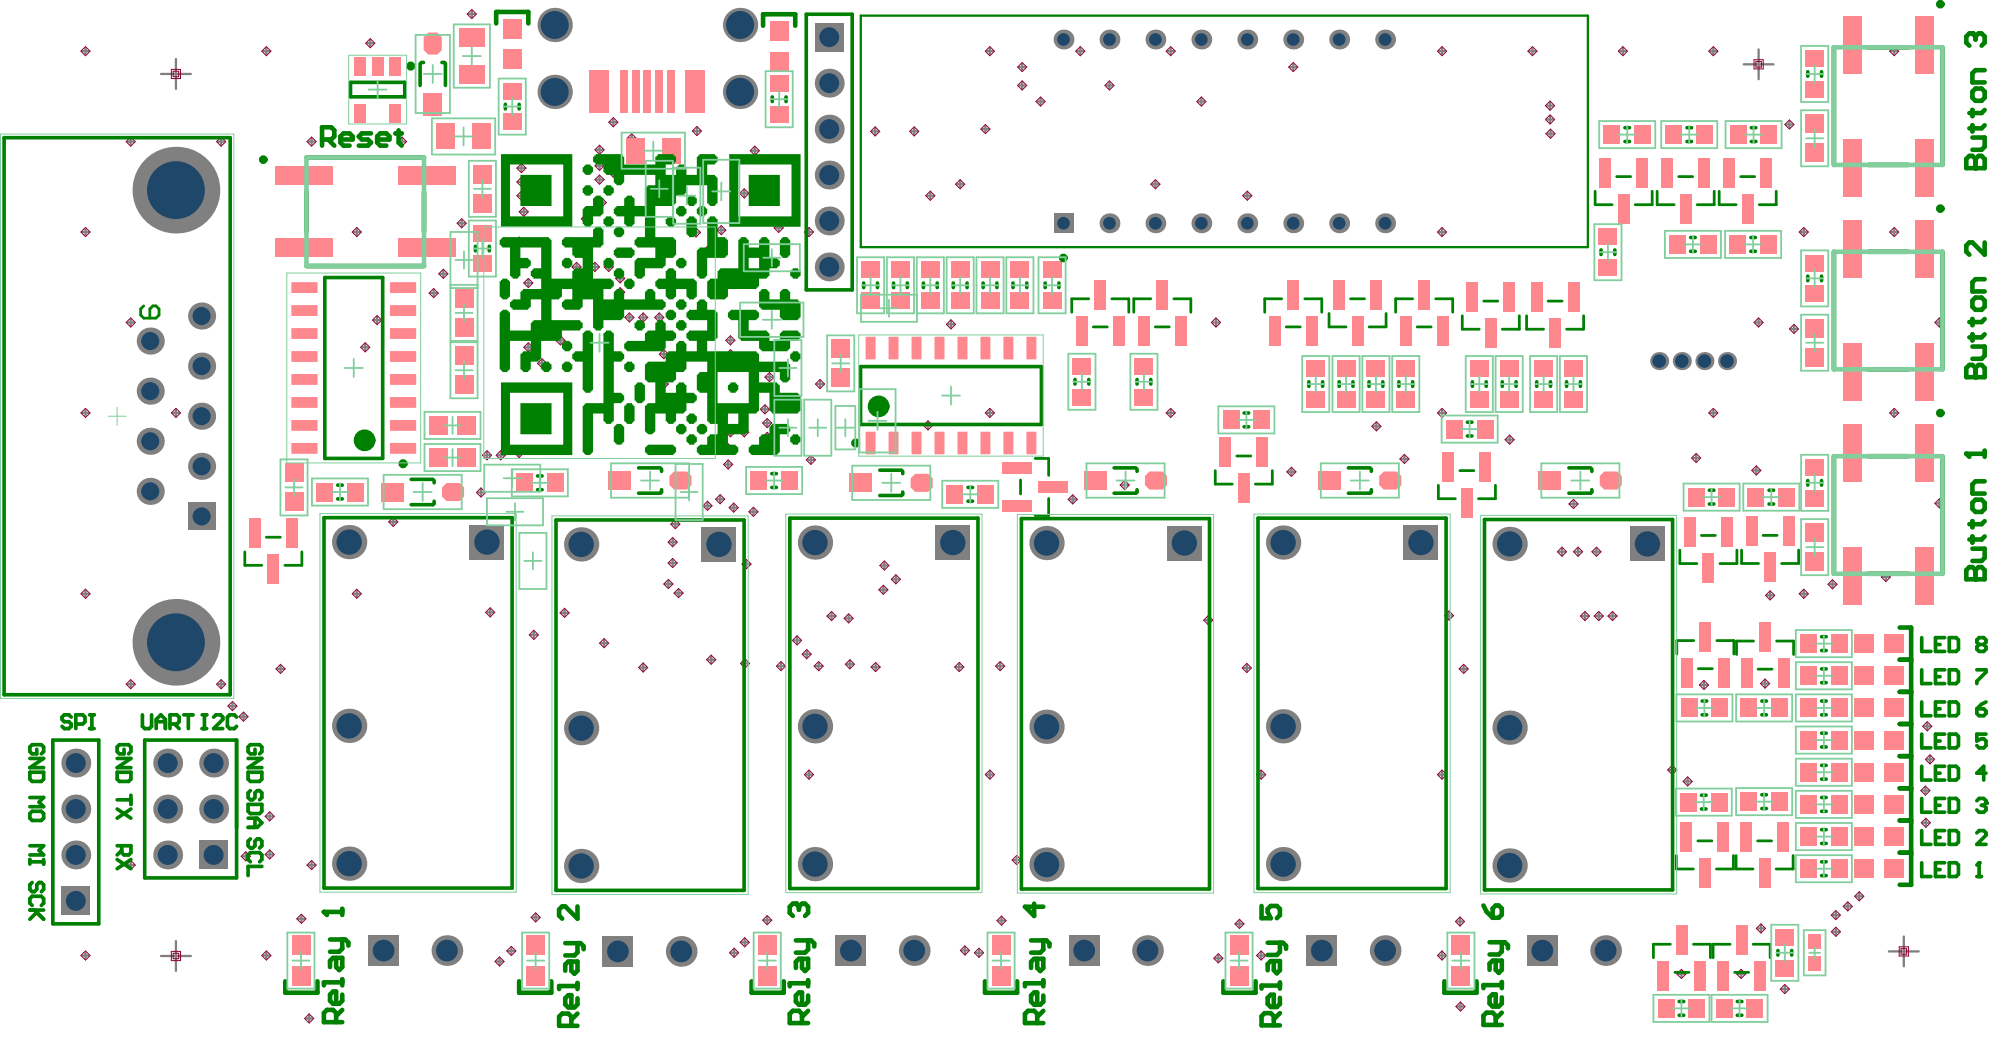
[picture p32: page 8]

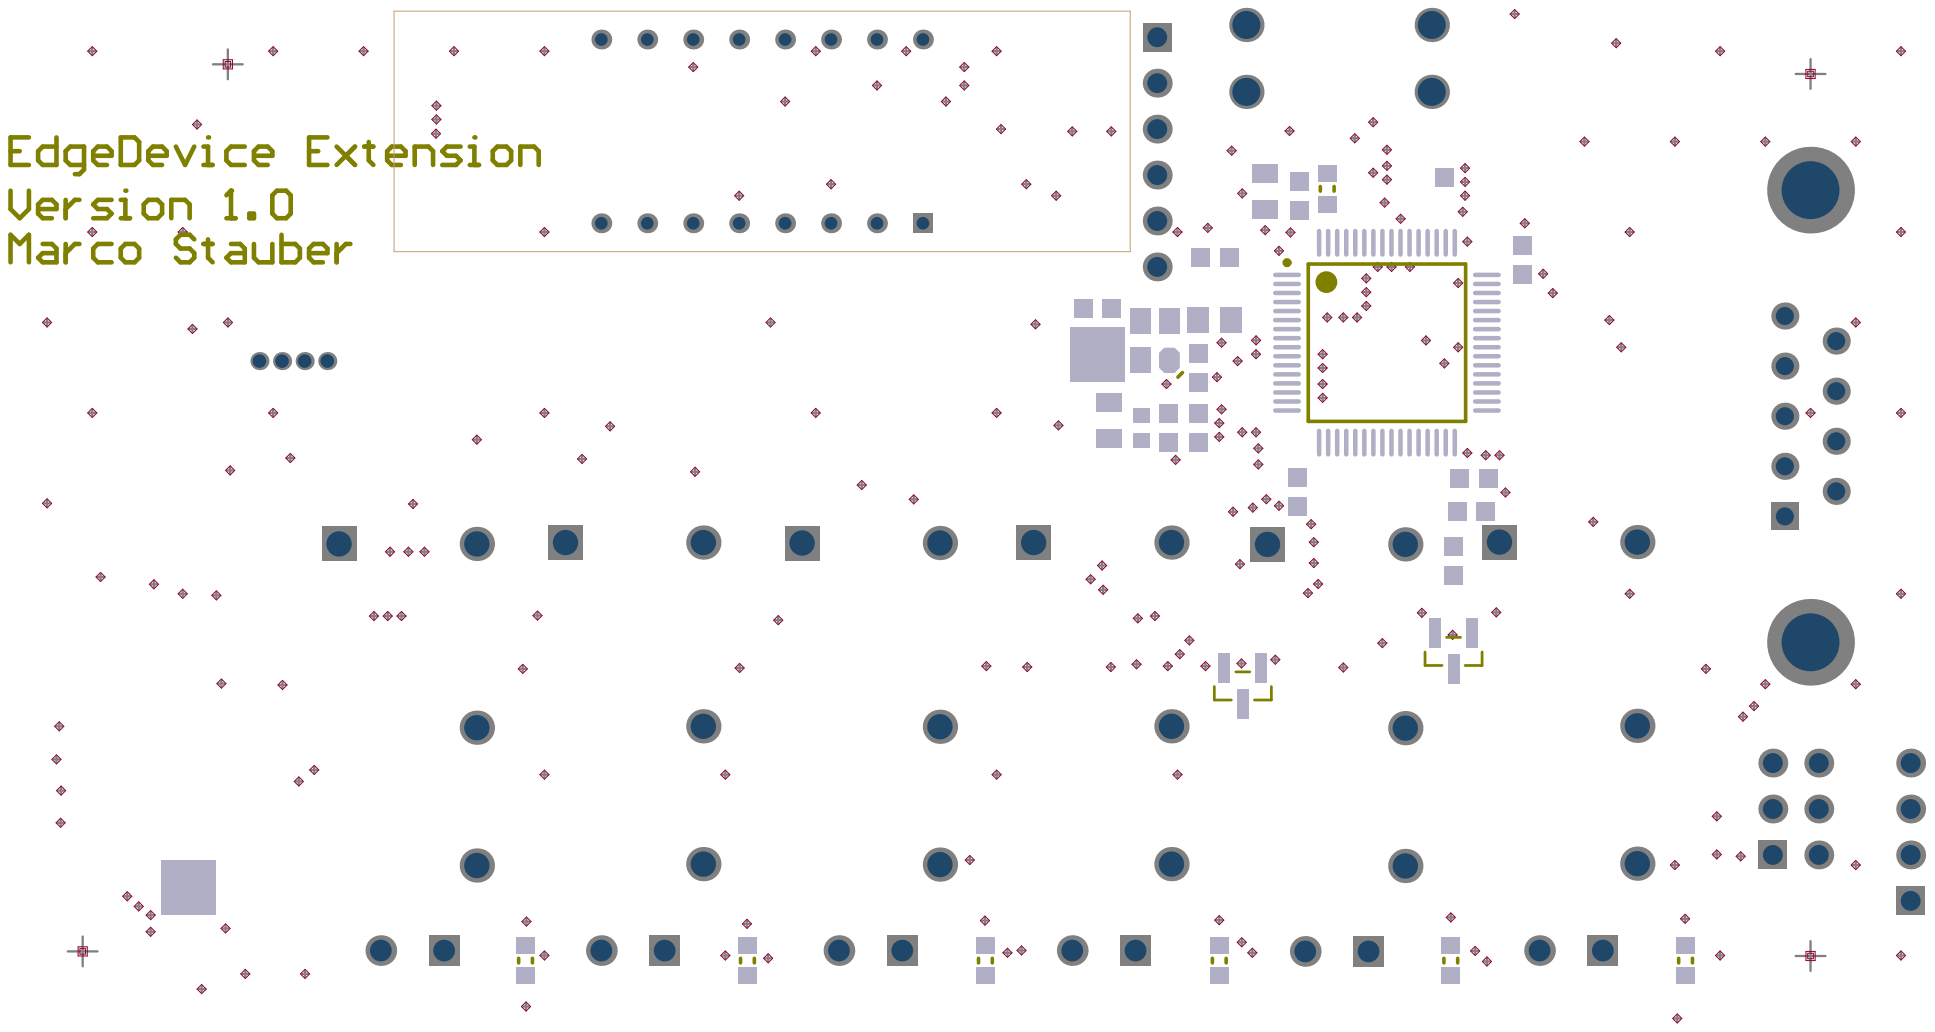
[picture p33: page 9]

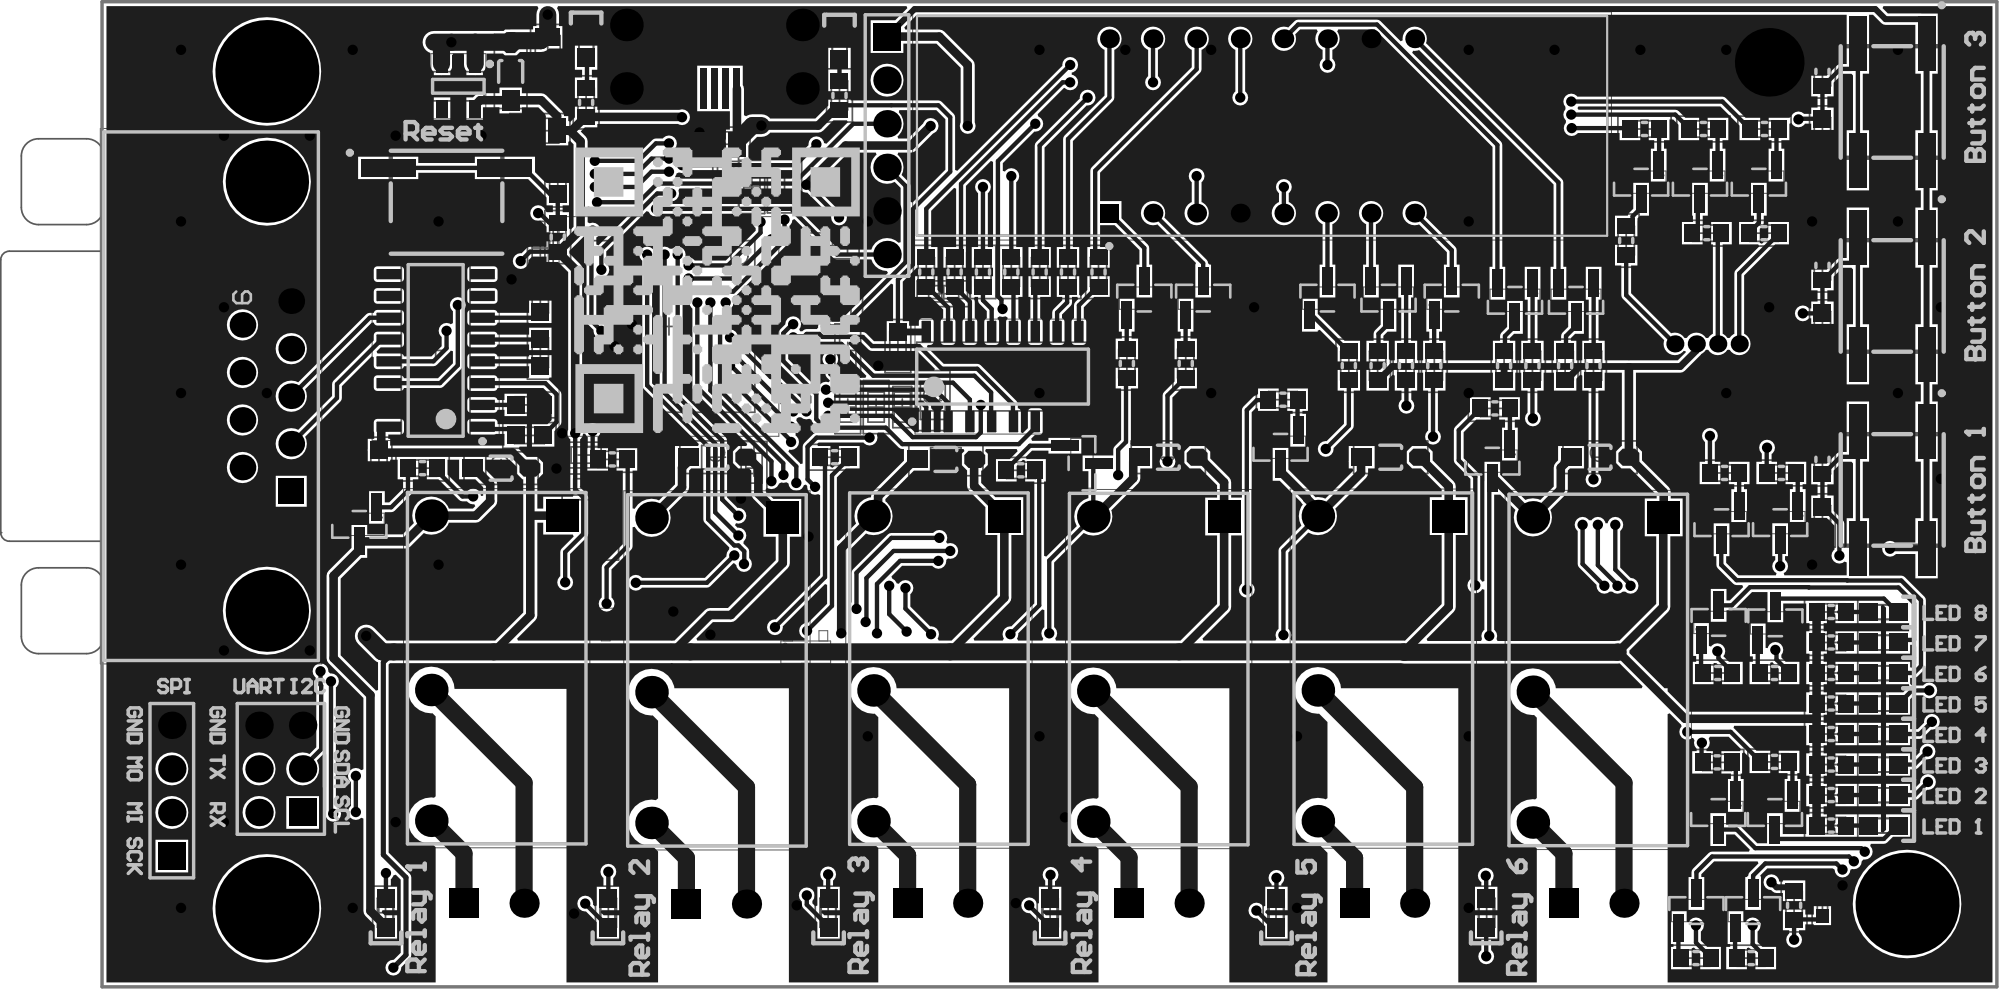
[picture p34: page 11]

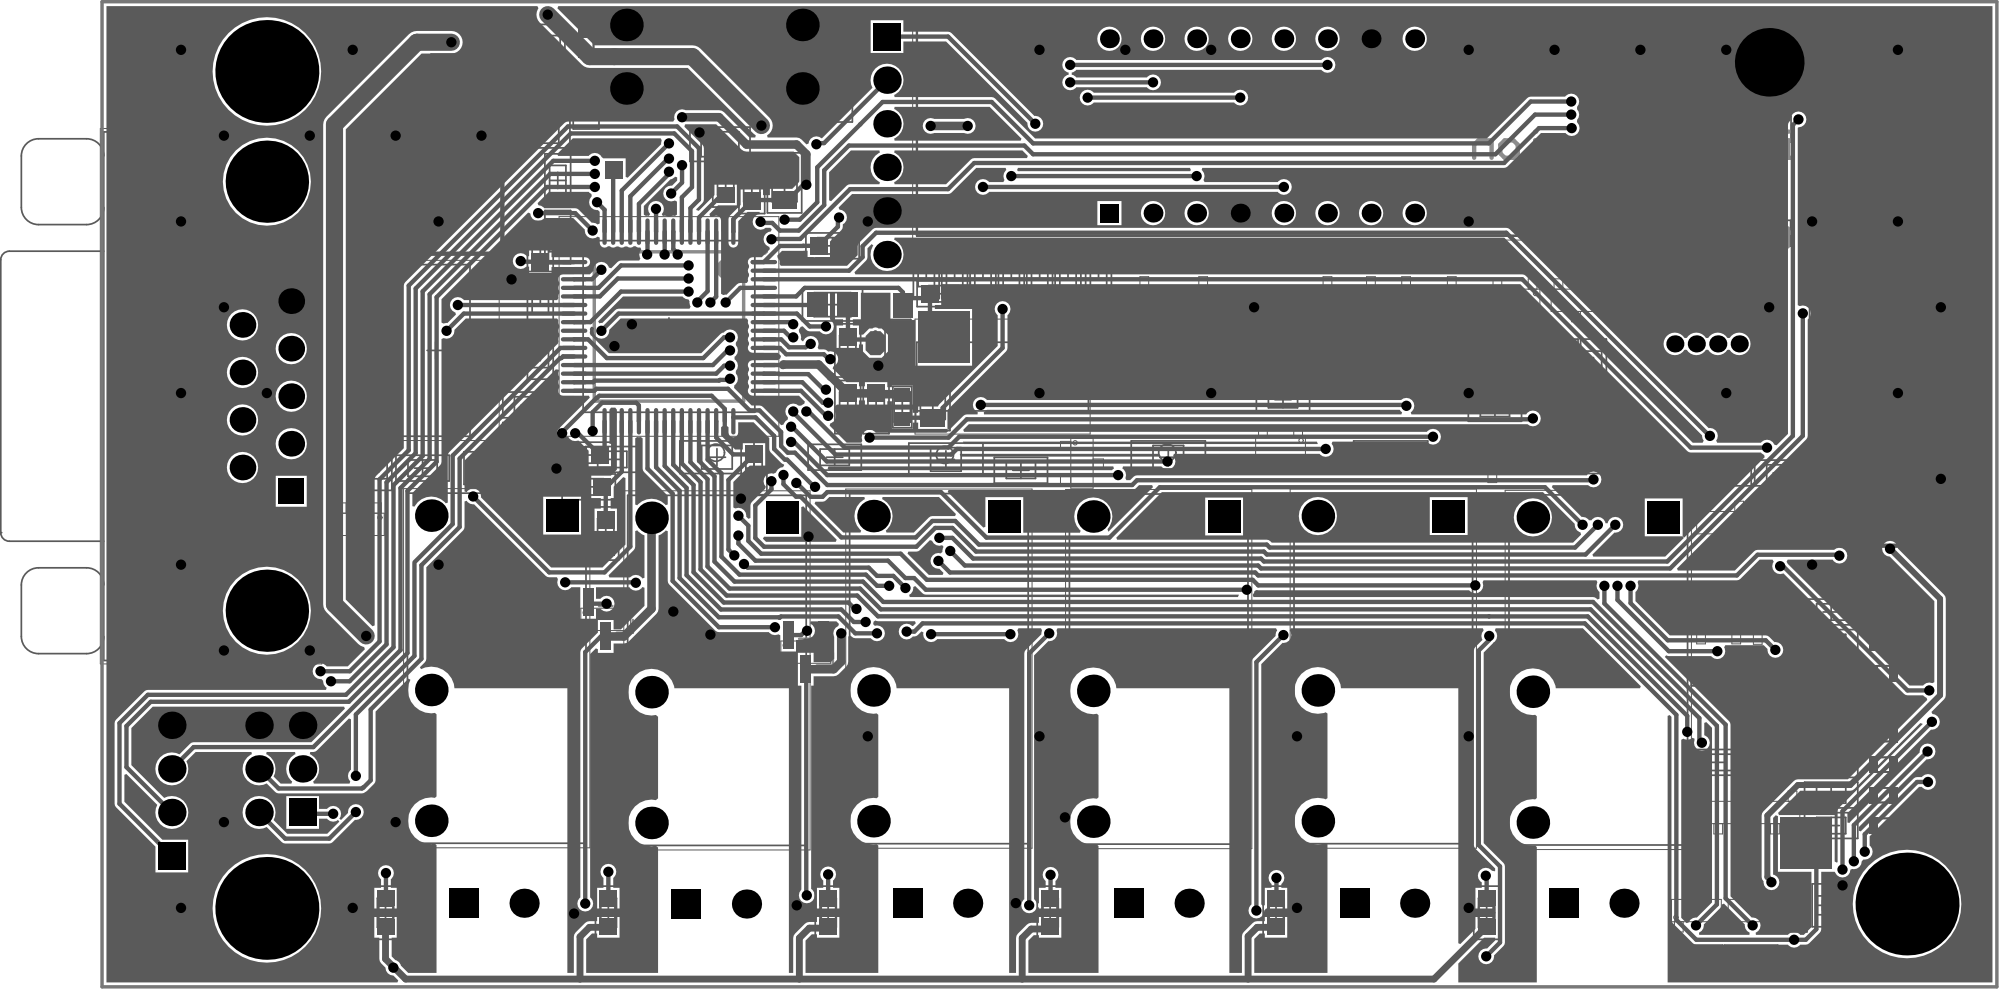
[picture p35: page 12]

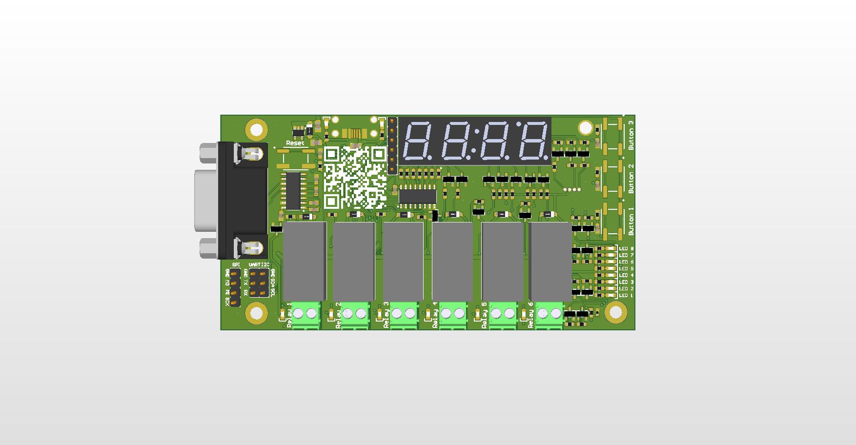
[picture p36: page 13]

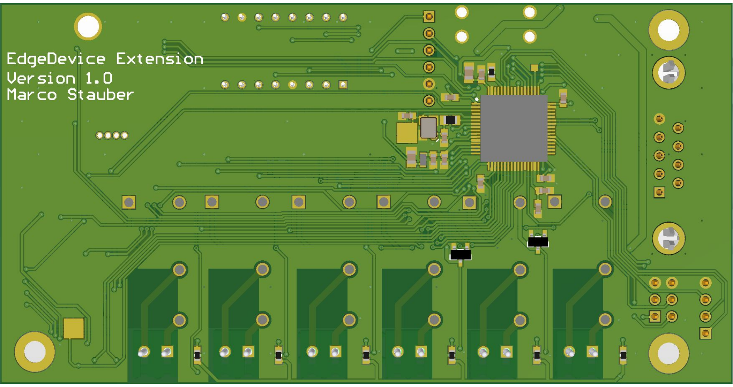
[picture p37: page 14]
