MXACE/Edge-Device-Extension/(list of files, drawings)

Other design files:
Extension-Board/PCB/PCB_Project/COM.SchDoc
Extension-Board/PCB/PCB_Project/extension.SchDoc
Extension-Board/PCB/PCB_Project/extensionV1.0.PcbDoc
Extension-Board/PCB/PCB_Project/IO.SchDoc
Extension-Board/PCB/PCB_Project/led.SchDoc
Extension-Board/PCB/PCB_Project/LIB.PcbLib
Extension-Board/PCB/PCB_Project/LIB.SchLib
Extension-Board/PCB/PCB_Project/PCB_Project.PrjPcb
Extension-Board/PCB/PCB_Project/PWR.SchDoc
Extension-Board/PCB/PCB_Project/relays.SchDoc
Extension-Board/PCB/PCB_Project/sensor.SchDoc
Extension-Board/PCB/PCB_Project/uc.SchDoc
