MXACE/Edge-Device-Extension/Extension-Board/Software/SW/Src/main.c

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

/* Includes ------------------------------------------------------------------*/
#include "main.h"

/* USER CODE BEGIN Includes */
#include "COM.h"
#include "CMDHandler.h"
#include "additional.h"
/* USER CODE END Includes */

ADC_HandleTypeDef hadc1;
DMA_HandleTypeDef hdma_adc1;

I2C_HandleTypeDef hi2c1;

SPI_HandleTypeDef hspi3;

UART_HandleTypeDef huart1;
UART_HandleTypeDef huart6;

void SystemClock_Config(void);
static void MX_GPIO_Init(void);
static void MX_USART1_UART_Init(void);
static void MX_ADC1_Init(void);
static void MX_I2C1_Init(void);
static void MX_SPI3_Init(void);
static void MX_USART6_UART_Init(void);
static void MX_DMA_Init(void);
/* USER CODE BEGIN 0 */

char rx_rs_buff[1];
char rx_com_buff[1];
		
uint32_t ADCvalues[1];
/* USER CODE END 0 */

/**
  * @brief  The application entry point.
  * @retval int
  */
int main(void)
{
  

  /* MCU Configuration--------------------------------------------------------*/

  /* Reset of all peripherals, Initializes the Flash interface and the Systick. */
  HAL_Init();

  /* Configure the system clock */
  SystemClock_Config();

  /* Initialize all configured peripherals */
  MX_GPIO_Init();
  MX_USART1_UART_Init();  
	MX_DMA_Init();
  MX_ADC1_Init();
  MX_I2C1_Init();
  MX_SPI3_Init();
  MX_USART6_UART_Init();

  /* USER CODE BEGIN 2 */
	//localtemp(0,1,1);
	HAL_ADC_Start_DMA(&hadc1,ADCvalues, 1);
	//HAL_ADC_Start(&hadc1);
	
	HAL_UART_Receive_IT(&huart1,(uint8_t*)rx_rs_buff,1);
	HAL_UART_Receive_IT(&huart6,(uint8_t*)rx_com_buff,1);	

  /* USER CODE END 2 */

  /* Infinite loop */
  /* USER CODE BEGIN WHILE */
	
	RS_TX("rdy;");
	init_seg();
	//UseSeg(1,1,2,3,4,0,1,0);
  while (1)
  {
		UseSeg(0,0,0,0,0,0,0,0);
		CH_HANDLER(0,"",0);
		button();
    /* USER CODE END WHILE */

    /* USER CODE BEGIN 3 */
  }
  /* USER CODE END 3 */
}

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
/* USER CODE BEGIN 4 */
void HAL_UART_RxCpltCallback(UART_HandleTypeDef *huart)
	{
		if(huart->Instance==USART6)				//COM
		{
			CH_BUFFER(rx_com_buff, 6);
			HAL_UART_Receive_IT(&huart6,(uint8_t*)rx_com_buff,1);
		}
		if(huart->Instance==USART1)				//RS
		{
			CH_BUFFER(rx_rs_buff, 1);
			HAL_UART_Receive_IT(&huart1,(uint8_t*)rx_rs_buff,1);
		}
		
		//singleChar = alpha[0];
		//CH_BUFFER(&singleChar);
	}

void HAL_ADC_ConvCpltCallback( ADC_HandleTypeDef * hadc)
{
	localtemp(ADCvalues,0/*,0*/);
	HAL_ADC_Start_DMA(&hadc1,ADCvalues, 1);
	//HAL_ADC_Start(&hadc1);
}
/* USER CODE END 4 */
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
