MXACE/Edge-Device-Extension/Extension-Board/Software/SW/Inc/main.h

#define LED_6_Pin GPIO_PIN_13
#define LED_6_GPIO_Port GPIOC
#define LED_5_Pin GPIO_PIN_14
#define LED_5_GPIO_Port GPIOC
#define LED_4_Pin GPIO_PIN_15
#define LED_4_GPIO_Port GPIOC
#define seg___phase_Pin GPIO_PIN_0
#define seg___phase_GPIO_Port GPIOC
#define seg___A_Pin GPIO_PIN_1
#define seg___A_GPIO_Port GPIOC
#define seg___D_Pin GPIO_PIN_2
#define seg___D_GPIO_Port GPIOC
#define seg___B_Pin GPIO_PIN_3
#define seg___B_GPIO_Port GPIOC
#define seg___C_Pin GPIO_PIN_0
#define seg___C_GPIO_Port GPIOA
#define seg___latch_Pin GPIO_PIN_1
#define seg___latch_GPIO_Port GPIOA
#define seg_DP_Pin GPIO_PIN_2
#define seg_DP_GPIO_Port GPIOA
#define seg_L1L2_Pin GPIO_PIN_3
#define seg_L1L2_GPIO_Port GPIOA
#define LED_3_Pin GPIO_PIN_5
#define LED_3_GPIO_Port GPIOA
#define LED_2_Pin GPIO_PIN_6
#define LED_2_GPIO_Port GPIOA
#define LED_1_Pin GPIO_PIN_7
#define LED_1_GPIO_Port GPIOA
#define Button_3_Pin GPIO_PIN_4
#define Button_3_GPIO_Port GPIOC
#define Button_2_Pin GPIO_PIN_5
#define Button_2_GPIO_Port GPIOC
#define Button_1_Pin GPIO_PIN_0
#define Button_1_GPIO_Port GPIOB
#define Relay_3_Pin GPIO_PIN_1
#define Relay_3_GPIO_Port GPIOB
#define Relay_2_Pin GPIO_PIN_2
#define Relay_2_GPIO_Port GPIOB
#define Relay_1_Pin GPIO_PIN_10
#define Relay_1_GPIO_Port GPIOB
#define seg_L3_Pin GPIO_PIN_12
#define seg_L3_GPIO_Port GPIOB
#define DIG1_Pin GPIO_PIN_13
#define DIG1_GPIO_Port GPIOB
#define DIG2_Pin GPIO_PIN_14
#define DIG2_GPIO_Port GPIOB
#define DIG3_Pin GPIO_PIN_15
#define DIG3_GPIO_Port GPIOB
#define DIG4_Pin GPIO_PIN_8
#define DIG4_GPIO_Port GPIOC
#define RGB_B_Pin GPIO_PIN_8
#define RGB_B_GPIO_Port GPIOA
#define RGB_R_Pin GPIO_PIN_11
#define RGB_R_GPIO_Port GPIOA
#define RGB_G_Pin GPIO_PIN_12
#define RGB_G_GPIO_Port GPIOA
#define Relay_4_Pin GPIO_PIN_2
#define Relay_4_GPIO_Port GPIOD
#define Relay_5_Pin GPIO_PIN_4
#define Relay_5_GPIO_Port GPIOB
#define Relay_6_Pin GPIO_PIN_5
#define Relay_6_GPIO_Port GPIOB
#define LED_8_Pin GPIO_PIN_8
#define LED_8_GPIO_Port GPIOB
#define LED_7_Pin GPIO_PIN_9
#define LED_7_GPIO_Port GPIOB
